LucaBrescia/theremin-psea/Theremin-frn.tex

%% This file has been automatically generated by `frontespizio'.
%% Don't use it as a model for a new frontispiece, use the
%% `frontespizio' environment in you document instead.
\documentclass [titlepage]{article}
\usepackage[utf8]{inputenc}
\usepackage [a4paper,left=1cm,bottom=1.5cm,right=1cm,top=1cm]{geometry}
\usepackage {graphicx}
\usepackage [svgnames]{xcolor}
\usepackage[nowrite,infront,standard,swapnames]{frontespizio}
\nofiles 
\fontoptionnormal 
\Universita {Brescia}
\Logo [3cm]{Logo_unibs.pdf}
\Dipartimento {Ingengeria dell'Informazione}
\Corso [Laurea magistrale]{Ingegneria Elettronica}
\Annoaccademico {2020--2021}
\Titoletto{Progetto di Sistemi Elettronici Analogici}
\Titolo {Circuito per la generazione del tono \\ (sinusoidale a frequenza variabile) per Theremin}
\Sottotitolo{Progetto n°17}
\NCandidati{Autori}
\Candidato [706005]{Luca Brescia}
\Candidato [89521]{Simone Pezzottini}
\begin {document}
\preparefrontpagestandard
\end {document}
