LucaBrescia/theremin-psea/Immagini/xr2206_pinout.pdf

SYMA2
SYMA1
WAVEA2
WAVEA1
GND
SYNCO
BIAS
FSKI

AMSI
STO
MO VCC

TC1
TC2
TR1
TR2

12345678
16
15
14
13
12
11
109
