LucaBrescia/theremin-psea/Theremin.pdf

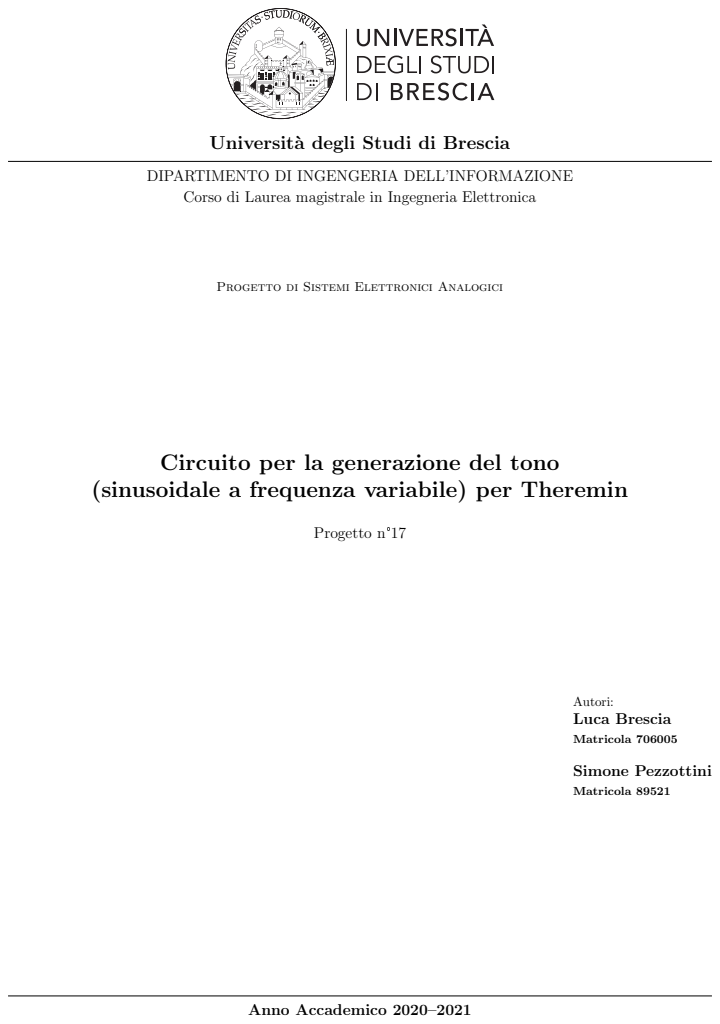
[picture p1: page 1]
Progetto n°17; Autori: Luca Brescia; Matricola 706005; Simone Pezzottini; Matricola 89521; Anno Accademico 2020–2021

Universit`a degli Studi di Brescia

DIPARTIMENTO DI INGENGERIA DELL’INFORMAZIONE
Corso di Laurea magistrale in Ingegneria Elettronica

Progetto di Sistemi Elettronici Analogici

Circuito per la generazione del tono

(sinusoidale a frequenza variabile) per Theremin

# Indice

Obiettivo | 2
1 Scelta dei componenti | 3
2 Scelte progettuali | 7
3 Risultati sperimentali | 16
4 Conclusioni | 33

# Obiettivo

Realizzazione di un tono a frequenza variabile nello spettro delle frequenze udibili [20Hz − 20kHz] utilizzando un VCO e una capacit`a variabile con il movimento di una mano seguendo lo schema a blocchi mostrato in Figura 1. Il segnale modulato avr`a un range di frequenze elevato, di conseguenza andr`a mixato ad una sinusoide a frequenza determinata, per riportare lo spettro del segnale nel range delle frequenze udibili, e opportunamente filtrato per eliminare le componenti indesiderate.

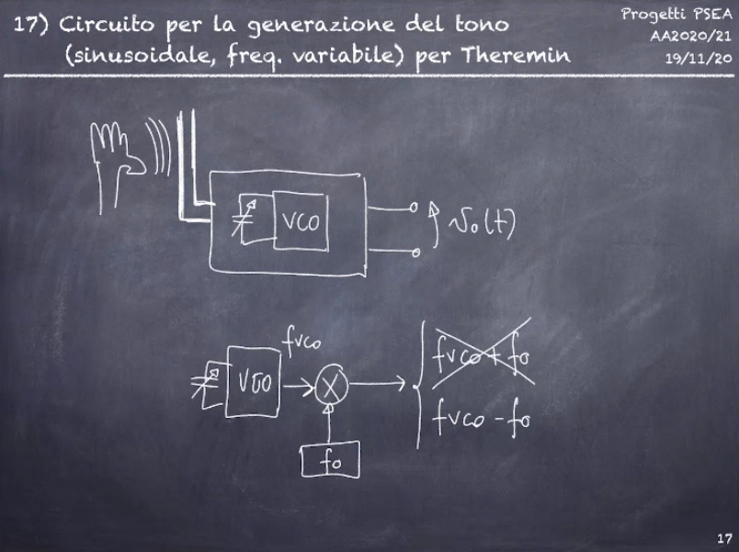
[picture p2: figure]

Figura 1: Schema generale di funzionamento di un circuito per la realizzazione di un tono.

In generale lo schema richiesto per la realizzazione del progetto potrebbe essere il seguente:

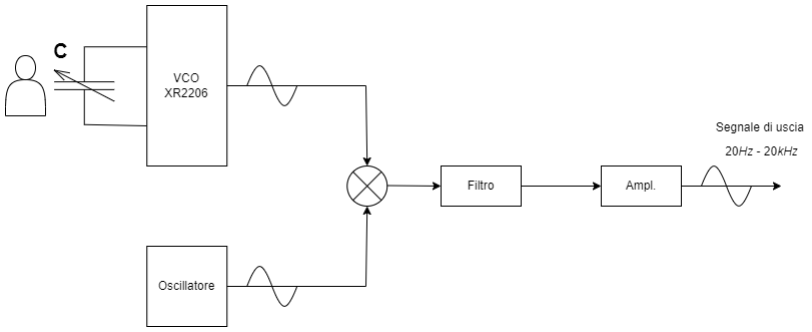
[picture p3: figure]

Figura 2: Schema a blocchi generale del progetto

# Capitolo 1

# Scelta dei componenti

I blocchi minimi necessari alla realizzazione di questo progetto sono:

1. Oscillatore sinusoidale a frequenza variabile(controllato in tensione (VCO));
2. Moltiplicatore analogico;
3. Oscillatore a frequenza fissata;
4. Filtro passa basso.
5. Filtro passa alto con Amplificazione

La scelta dei componenti `e stata fatta considerando le caratteristiche del segnale da generare. In particolare, volendo realizzare uno shift in frequenza, pertanto vi `e la necessit`a di lavorare con integrati con una banda passante adeguata. Avendo a disposizione una serie limitata di componenti si `e deciso di utilizzare i seguenti:

1. per l’ossillatore a frequenza variabile si `e scelto l’oscillatore monolitico XR2206 come VCO;
2. Il moltiplicatore analogico AD633 per lo shift frequenziale;
3. L’amplificatore operazionale LF353N per la realizzazione dell oscillatore a ponte di Wien per la generazione della sinusoide di riferimento;
4. L’amplificatore LF356P per la realizzazione di filtro passa basso.
5. L’amplificatore UA741 per la realizzazione dei filtri passa alto.

### 1.1 Amplificatori operazionali LF353N, LF356P e uA741

La scelta di questi componenti tra quelli disponibili `e stata fatta principalmente per le bande bassanti dei dispositivi.
Sono necessari componenti a banda elevata poich´e, come risulta dal capitolo 3.3, si deve lavorare con frequenze dell’ordine delle centinaia di kHz.
Infatti le bande in gioco sono di circa 3MHz per LF356P mentre 5MHz per LF353N. Ad esempio, l’UA741 ha un GBP di 1MHz tipico. I primi due operazionali sono stati scelti per:
1. LF356N per l’oscillatore armonica fondamentale
2. LF353P per il filtro passa basso del 4o ordine.

Importante osservare che l’LF356P ha al suo interno due amplificatori operazionali per cui `e stato scelto per la realizzazione del filtro del 4o ordine in modo da ridurre il numero di integrati per la realizzazione del dispositivo.Inoltre, l’LF353N, avente una GBP maggiore (5MHz ), permette di generare sinusoidi con un range di frequenze maggiore; altro motivo per cui si sono scelti i componenti come spiegato sopra. L’UA741 viene impiegato come filtro attivo passa alto del primo ordine (ecomeamplif icatoref inale) per togliere le componenti inferiori a 20Hz come richiesto dal progetto e sfruttare contemporaneamente la banda passante ridotta del dispositvo al fine di attenuare le alte frequenze indesiderate.
I motivi per cui le frequenze in gioco risultino essere elevate sono indicate nel capitolo 3.3.

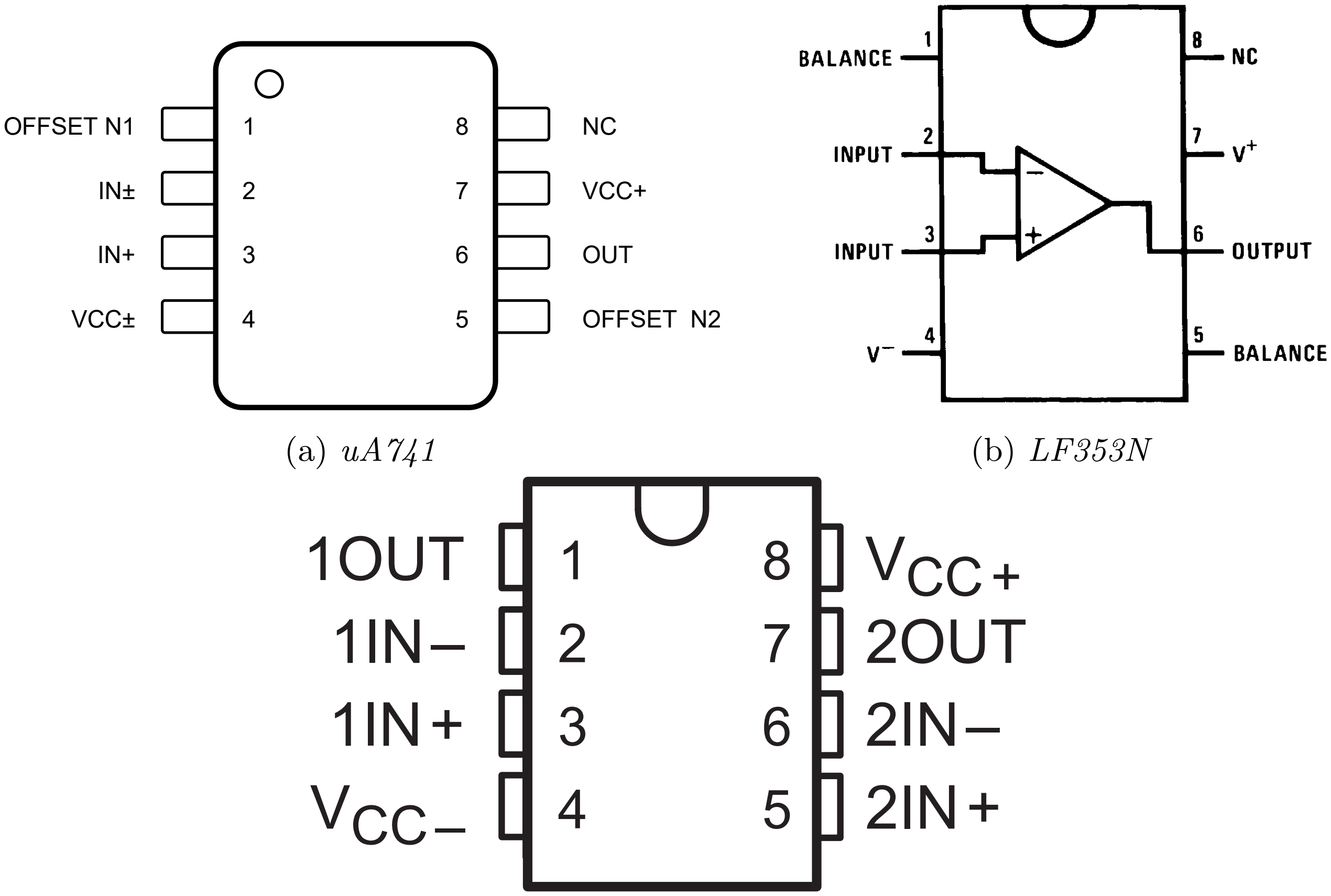
[picture p4: figure]
OFFSET N1; VCC+; OUT; 4VCC±; OFFSET N2; 1OUT 1IN– 1IN+ VCC –; VCC + 2OUT 2IN– 2IN+

(c) LF356P

Figura 1.1: PinOut dei tre Amplificatori Operazionali usati

### 1.2 Oscillatore monolitico XR2206

Si `e scelto di utilizzare XR2206 perch´e permette la generazione di diverse forme d’onda sinusoidali, onde quadre, rampe, onde triangolari ed impulsi garantendo un’alta precisione, stabilit`a e una bassa distorsione. L’ampiezza e la frequenza dei segnali in uscita sono direttamente modulabili dall’integrato, gestendo opportunamente gli ingressi. La gamma di frequenze generabili va da 0.01 Hz a 1 MHz, quindi perfetto per le specifiche richieste dal progetto. In Figura 1.2 `e mostrato lo schema a blocchi del componente.

11 SYNCO

VCO

4

VCC
12

GND
10

BIAS

Timing
Capacitor

TC1 5

TC2 6

Timing
Resistors

TR1 7

TR2 8

FSKI | 9
AMSI | 1

Current
Switches | Multiplier
And Sine
Shaper

2 STO

3 MO

13WAVEA1

14WAVEA2

15SYMA1

16SYMA2

+1

(a) Schema dei collegamenti interni

PIN DESCRIPTION

Pin # | Symbol | Type | Description
1 2 3 4 5 6 7 8 9 10 11 12 13 14 15 16 | AMSI STO MO VCC TC1 TC2 TR1 TR2 FSKI BIAS SYNCO GND WAVEA1 WAVEA2 SYMA1 SYMA2 | I O O I I O O I O O I I I I | Amplitude Modulating Signal Input. Sine or Triangle Wave Output. Multiplier Output. Positive Power Supply. Timing Capacitor Input. Timing Capacitor Input. Timing Resistor 1 Output. Timing Resistor 2 Output. Frequency Shift Keying Input. Internal Voltage Reference. Sync Output. This output is a open collector and needs a pull up resistor to VCC. Ground pin. Wave Form Adjust Input 1. Wave Form Adjust Input 2. Wave Symetry Adjust 1. Wave Symetry Adjust 2.
(b) Descrizione in dettaglio dei pin

Figura 1.2: Schema a blocchi dell’oscillatore monolitico XR2206

La frequenza di oscillazione pu`o essere determinata agendo sulla capacit`a o sulla resistenza equivalente collegate ai pin opportuni del componente, come riportato nel capitolo 2.

### 1.3 Moltiplicatore analogico AD633

La scelta del moltiplicatore analogico AD633 `e stata obbigata in quanto tra i componenti a disposizione non vi erano altre proposte. Tuttavia, garantisce delle buone prestazioni permettendo di restare nelle specifiche di progetto. Infatti, possiede elevate impedenze d’ingresso sia sugli ingressi differenziali X e Y , che sull’ingersso sommatore Z, una bassa impedenza d’uscita che permette quindi di disaccoppiare la parte a monte del circuito con quella che si trova a valle e lavora con una larghezza di banda pari ad 1 MHz e uno slew rate pari a 20 V/µS. La Figura 1.3 mette in evidenza che il componente inizia ad attenuare il segnale ad una frequenza inferiore ripetto alla banda passante teorica indicata, tagliando intorno ai 500kHz. Dal punto di vista teorico, questo non impone una limitazione ai fini del progetto.

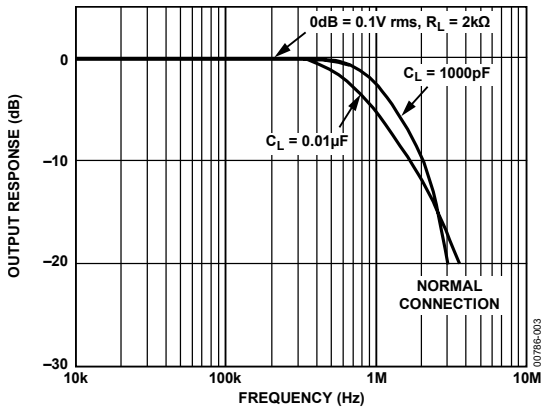
[picture p5: figure]
FREQUENCY (Hz); OUTPUT RESPONSE (dB); 10M⁰⁰⁷⁸⁶⁻⁰⁰³; NORMAL CONNECTION; 0dB = 0.1V rms, RL

Figura 1.3: Banda passante del moltiplicatore analogico AD633

La Figura 1.4 mostra sia il pinout che lo schema blocchi interno dell’AD6333. Il segnale in uscita dal mixer si calcola con la seguente equazione:

W =

(X1 − X2)(Y 1 − Y 2)
10[V ]
+ Z | (1.1)

L’Equazione 1.1 ci dice che il segnale viene attenuato di un fattore 10, quindi sar`a necessaria una compensazione negli stadi successivi come viene mostrato nella Sezione 3.5.
Analizzando il caso che gli ingressi X2, Y2 e Z collegti a massa, ovvero che diano contributo nullo. L’Equazione 1.1 diventa:

W =

X1 ∗ Y 1
10[V ]

(1.2)

Considerando che i due ingressi siano sinusoidali:

X1 = A sin(ω1t + φ1) | (1.3)
Y 1 = B sin(ω2t + φ2) | (1.4)

W =

AB
2

[cos((ω1 − ω2)t + (φ1 − φ2)) − cos((ω1 + ω2)t + (φ1 + φ2))] 1 10[V ]

| (1.5)

Aggiungendo l’ipotesi che le due sinusoidi abbiano fase nulla, l’Equazione 1.5 diventa:

W =

AB
2

[cos((ω1 − ω2)t) − cos((ω1 + ω2)t)] 1 10[V ]

| (1.6)

Dunque, all’uscita del mixer si avr`a un segnale dato dalla combinazione delle due sinusoidi in ingresso, le cui componenti spettrali saranno date una dalla somma delle componenti spettrali delle delle singole e l’altra dalla loro differenza. Quindi, inserendo un opportuno filtro passa basso, si va a selezionare solo la componente spettrale d’interesse ovvero quella compresa tra 20 Hz e 20 kHz.

AD633JN/AD633AN

1

1

A

1
10V
X1 | 1
X2 | 2
Y1 | 3

4Y2

8 +VS

### 7 W

### 6 Z

5 –VS

Figura 1.4: PinOut e schema a blocchi dell’AD633

# Capitolo 2

# Scelte progettuali

Nella realizzazione di questo progetto si deve prestare particolare attenzione allo spettro delle frequenze del segnale di uscita. Nello specifico, si deve valutare la distorsione armonica totale (THD) del segnale di uscita osservando quanto le armoniche a frequenza diversa da quella desiderata, anche generate da disturbi intrinsechi del sistema, influiscano sovrapponendosi all’armonica a frequenza desiderata. Per ridurre l’effetto delle armoniche a frequenza esterna alla banda udibile si `e scelto di introdurre cascate di filtri passa alto e passa basso in modo da creare un insieme di filtri passa-banda che producano un effetto accettabile per l’esperienza. Di seguito `e riportato lo schema a blocchi del sistema:

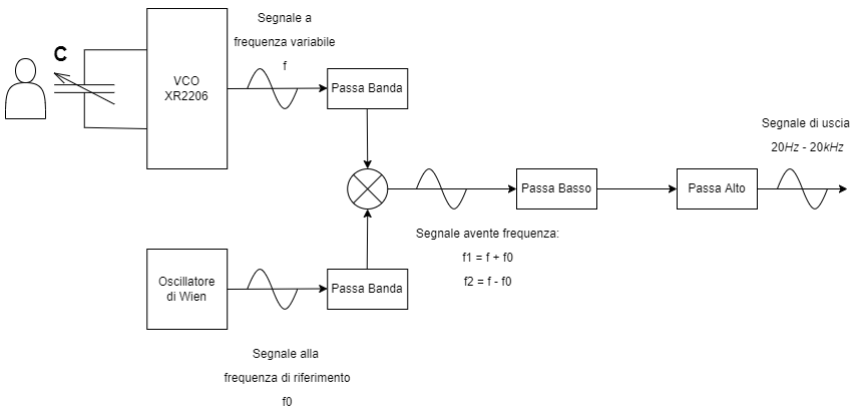
[picture p6: figure]

Figura 2.1: Schema a blocchi del sistema realizzato

Nelle Sezioni 2.1 2.2 1.3 2.4 vengono analizzate singolarmente le scelte effettuate per ogni singolo blocco del sistema.

### 2.1 VCO

Il VCO, Voltage Controlled Oscillator, `e un generatore di segnali che modifica la frequenza di oscillazione del segnale generato in funzione della tensione applicata al suo ingresso.
In relazione all’integrato utilizzato, il cui schema interno `e riportato in figura Figura 2.2, la frequenza di oscillazione f0 viene controllata da una capacit`a esterna C, detta capacit`a di timing collegata tra i pin5 e pin6 e dalla resistenza R posta in ingresso ai pin7 e pin8. Essa viene calcolata come:

f0 =

1
RC | (2.1)

Regolando il valore di R, dato dalla somma di R1+1kΩ, e di C, si imposta a piacere la frequenza di oscillazione. Nel progetto si `e scelto di utilizzare una resistenza R fissa in quanto si ha una capacit`a variabile per la regolazione della frequenza.

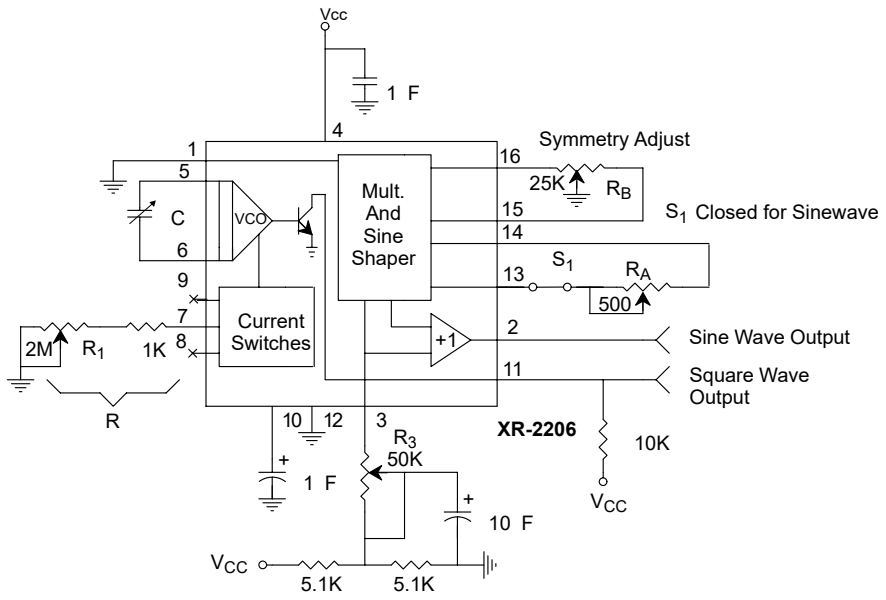
[picture p7: figure]
Symmetry Adjust; Sine Wave Output; Square Wave Output; Mult. And Sine Shaper; Current Switches; VCC; VCO; Vcc; S1 Closed for Sinewave

Figura 2.2: Schema a blocchi interno dell’oscillatore monolitico XR2206

Come consigliato da datasheet, per garantire una buona stabilit`a in temperatura, si `e scelto di utilizzare valori di R compresi tra 4kΩ < R < 200kΩ e valori di C compresi tra 1µF < C < 100µF.
Avendo una capacit`a variabile, in quanto dipendendente dalla posizione della mano dell’utente e dalla geometria dell’antenna realizzata, si `e scelta una R di 100kΩ per cercare di rispettare, almeno in parte, il range fornito dal datasheet per garantire una buona stabilit`a in temperatura.

### 2.2 Oscillatore sinusoidale di Wien

Per la realizzazione di un segnale sinusoidale a frequenza fissata si `e scelto di utilizzare un oscillatore in configurazione a ponte di Wien auto-avviante, il cui schema `e riportato in Figura 2.3

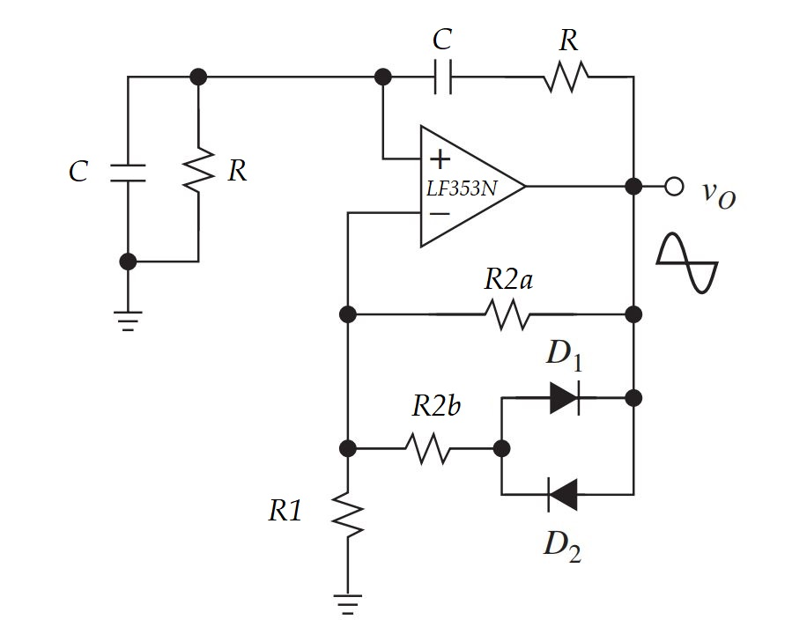
[picture p8: figure]

Figura 2.3: Schema generale di un oscillatore a ponte di Wien auto-avviante. A sinistra lo schema utilizzato per il progetto.

Analizzando la f.d.t del circuito, riportata nell’equazione 2.2 si osserva che il prodotto A · B deve essere 1, overo che sia soddisfatta la condizione di risonanza ω = ω0.

T(jω) =

1 + R2
R1
3 + j(

ω
ω0

−

ω0
ω

)

(2.2)

Il blocco di forward A `e rappresentato dal guadagno del circuito ovvero:

A = 1 +

R2
R1

(2.3)

Mentre, in presenza di R e C di valore unico, il blocco di feedback B `e rappresentato dall’equazione:

B =

1
3 + jωRC − j

1
ωRC

(2.4)

Da questo si possono avere tre casi:
1. T(jω) < 1: si ha una situazione stabile, in cui i segnali tendono a zero. Perch´e si hano due poli complessi coniugati a parte reale negative, che danno origine ad una sinusoide smorzata esponenzialmente.

2. T(jω) > 1: si ha una situazioneinstabile, dove ogni disturbo con contributo spettrale vicino ad ω0 viene amplificato rigenerativamente. Pertanto l’amplificatore operazionale satura. Questo avviene perc´e si hanno due poli complessi coniugati a parte reale positiva, che danno origine ad una sinusoide con ampliezza crescente esponenzialmente.
3. T(jω) = 1: si ha una situazione di stabilit`a. Perch´e si hanno due poli complessi coniugati a parte reale nulla, immaginari puri, che danno origine ad una sinusoide con ampiezza costante.

Per l’innesco delle oscillazioni `e necessario che il guadagno ad anello aperto sia inizialmente A·B > 1 ed A > 3 per poi assestarsi a A·B = 1 ed A = 3. La tecnica pi`u semplice consiste nel disporre due diodi in antiparallelo lungo l’anello di retroazione dell’amplificatore operazionale. Quando VO `e bassa i diodi presentano un’alta resistenza differenziale mentre all’aumentare di VO essa diminuisce.
Per rispettare le condizioni di lavoro imposte, il guadagno A deve essere posto, circa, all’85% del suo valore nominale (A=2,5 — 2,55) cos`ı si fa in modo modo che A > 3 all’avvio che poi si riduce ad A=3 a regime.

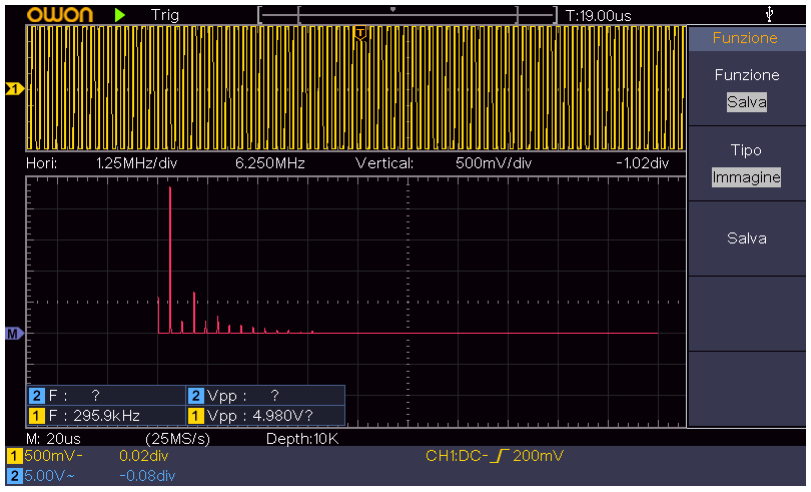
[picture p9: figure]

Figura 2.4: FFT della sinusoide a 295kHz in uscita dall’oscillatore acquisita tramite oscilloscopio

La frequenza di oscillazione si ottiene con l’Equazione 2.5:

f0 =

1
2πRC | (2.5)

Per la valutazione della distorsione della sinusoide ottenuta si utilizza il calcolo del THD riportato nell’Equazione 2.6:

T HD(%) = 100 ·

qP∞
2 V

2
n
V1
| (2.6)

Tutti i valori di tensione devono essere in RMS:

VRMS =

V
√
2

(2.7)

La presenza di un THD pi`u o meno accettabile `e indice di un andamento sinusoidale in uscita pi`u o meno ideale, ossia avente una fft che presenta una sola riga spettrale. L’aggiunta di nuove armoniche pu`o essere cuasata dalla sensibilit`a alle temperature dell’oscillatore di Wien, che porta anche ad una variazione delle ampiezze. Un’altra possibile fonte di disturbi e/o distorioni `e la saturazione dell’amplificatore utilizzato per realizzare l’oscillatore, bisogna quindi essere sempre attenti a non portare l’amplificatore a saturare il segnale.

### 2.3 Moltiplicatore analogico

Come segue dalla teoria dei segnali, alla moltiplicazione di due segnali nei tempi corrisponde la convoluzione degli stessi in frequenza. Questo porta ad ottenere due sinusoidi centrate a frequenza ω1 + ω2 e ω1 − ω2.
In Figura 2.5 viene mostrato il risultato ottenuto moltiplicando una sinusoide ottenuta precedentemente con l’oscillatore di Wien, illustrato nella Sezione 2.2, avente una ω0 di 45kHz, e una sinusoide generata dal generatore di funzione ad una frequenza di 20kHz.

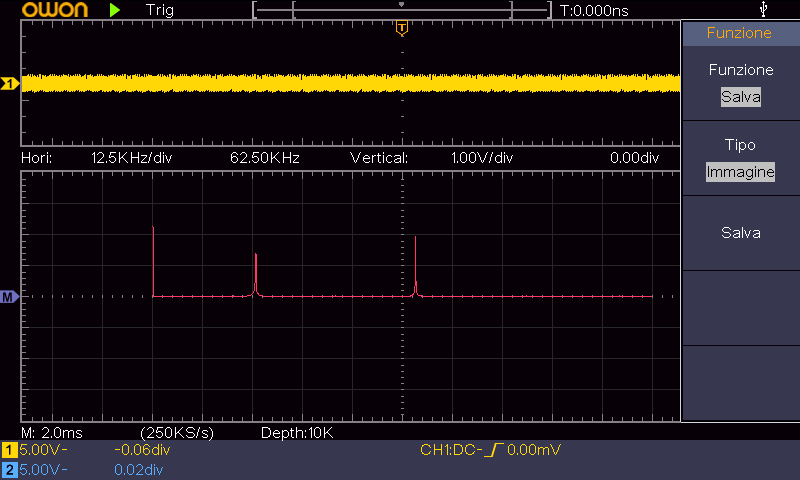
[picture p10: figure]

Figura 2.5: FFT del segnale in uscita dall’AD633, con test tra Oscillatore di Wien avente ω0 = 45kHz 12V picco e generatore di funzione con segnale 20 Khz e 2.5V picco.

Essendo i due segnali di 20kHz e 45kHz rispettivamente, dalla Figura 2.5 si pu`o notare come vengano generate due sinusoidi aventi armoniche fondamentali a (45 −20)kHz e (45 + 20)kHz. Inoltre, le ampiezze misurate risultano comparabili con i risultati teorici in quanto l’ampiezza di picco dei due segnali `e di 12V e 2.5V rispettivamente, che vengono moltiplicati tra loro e scalati di un fattore 10, come specificato nel datasheet del componente. Sempre in riferimento alla Figura 2.5 si pu`o notare anche come le due ampiezze non siano uguali: questo `e un errore dovuto alla non-linearit`a del componente. Tuttavia, per la nostra applicazione questo errore `e irrilevante in quanto interessa maggiormente la componente frequenziale del segnale.

### 2.4 Filtro LP del quarto ordine

Il prodotto di due sinusoidi del mixer porter`a in uscita due sinusoidi a frequenze diverse ovvero una sar`a ωwien + ωV CO e l’altra a ωwien − ωV CO. Per rientrare nelle specifiche di progetto, `e stato necessario introdurre un filtro passa-basso che permetta di ottenere in uscita al sistema solo la componente armonica ωwien − ωV CO.
Volendo realizzare un filtro molto selettivo e, avendo il componente LF353P al suo interno due amplificatori, si `e scelto di utilizzare un filtro attivo di ordine 4, realizzandolo tramite un filtro di Chebychev con due celle Sallen-Key in casacata.

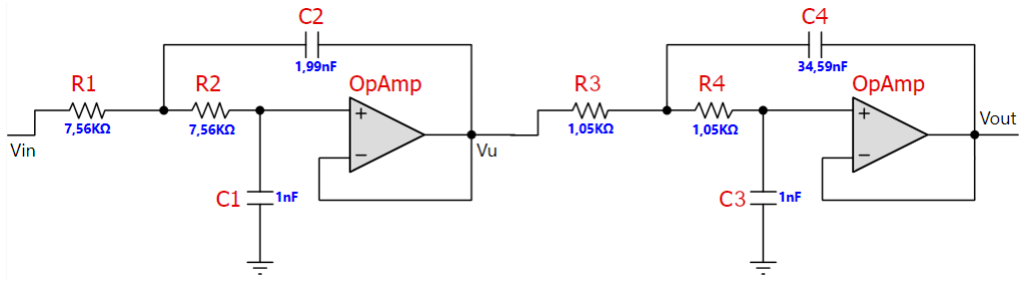
[picture p11: figure]

Figura 2.6: Filtro attivo di ordine 4.

La risposta in frequenza teorica del filtro risulta essere in modulo quella riportata nel diagramma di Bode mostrato in Figura 2.7.

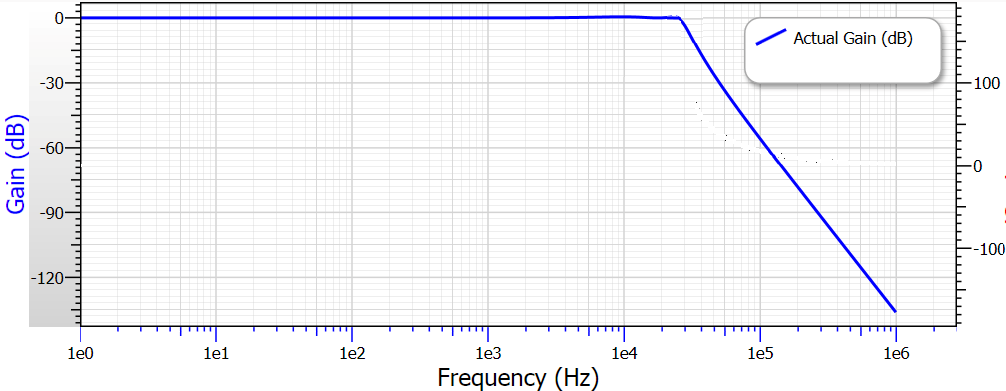
[picture p12: figure]

Figura 2.7: Diagramma di Bode del modulo del filtro.

La funzione di trasferimento del filtro del quarto ordine pu`o essere vista come il prodotto in cascata delle funzioni di trasferimeto delle due celle Sellen-Key del secondo ordine.
La funzione della prima cella risulta:

H1(s) = Vin
Vu

=

1
1 + sC1(R1 + R2) + s

2C1C2R1R2

(2.8)

Mentre la funzione di trasferimento della seconda cella risulta essere:

H2(s) = Vu

Vout

=

1
1 + sC3(R3 + R4) + s

2C3C4R3R4

(2.9)

La funzione di trasferimento totale del filtro sar`a quindi data dal prodotto delle due Equazioni 2.8e 2.9:

H(s) = H1(s)H2(s) = Vin
Vu

Vu

Vout

=

Vin

Vout

(2.10)

### 2.5 Filtro passa alto del primo orine con amplificazione

Come mostrato nello schema riportato in figura 2.1, il sistema presenta come ultimo blocco un filtro passa alto, per tagliare tutte le frequenze inferiori ai 20 Hz, come da specifica. Inoltre, oltre a filtrare le basse frequenze si effettua anche un’amplificazione per compensare il fattore di attenuazione introdotto dal mixer.

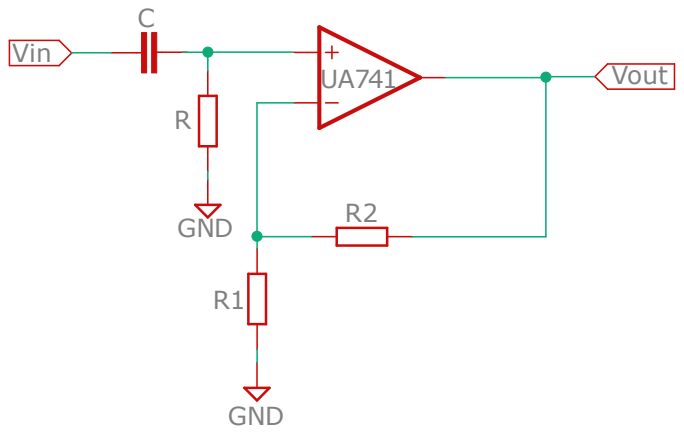
[picture p13: figure]
GND; Vin; Vout

Figura 2.8: Schematico del filtro passa alto attio del primo ordine, con guadagno per compensare l’attenuazioen itordotta dal mixer. Posto in uscita dal filtro passa basso del quarto ordine.

La funzione di trasferimetno del filtro pu`o essere vista come il prodotto di due dieversi blocchi. Il blocco di guadagno non invertente riportato nell’equazione 2.11, ovveor il blocco di retroazione. Che per compensare il fattore di attenuazione introdotto dal mixer il guadagno dovr`a essere pari a 10.

A = 1 +

R2
R1

(2.11)

Il secondo blocco invece conprende la parte di filtraggio e la sua funzione di trasferimento `e quella riportata nell’eqauzione 2.12.

H(jω) = | jωRC
1 + jωRC | (2.12)

Moltiplicando l’equazione 2.11 con l’equazione 2.12 e passando nel dominio di Laplace, ovvero ponendo jω = s, si ottine la finzione di trasferimento complessiava del filtro attivo riportata nell’equazione 2.13.

H(s) = sRC
1 + sRC (1 + R2
R1
) | (2.13)

La frequenza di taglio si ottine con la formula riportata nell’equazione 2.14

ft =

1
2πRC | (2.14)

Imponendo una C pari a 47nF, per ottenere una ft pari a 20 Hz, si deve avere una R pari a 169.3kΩ.

### 2.6 Filtro passa banda passivo

Anche se nello schema riportato in figura 2.1 i filtri passa banda vengono posti all’inizio, sono stati messi come ultimo sezione in quanto la loro necessit`a si `e presentata solo dopo una prima anlisi dei segnali in uscita dall’XR2206 edall’oscillatore riportato nella sezione 2.2. Visto che i due segnali impiegati nella misurazioni presentavano delle componenti in continua, sopratutto il segnale in uscita dall’XR2206 che introduce un offset per garantire l’oscillazione con un’alimetazione singola, come spiegato nella sezione 1.2; mentre l’oscillatore nella sezione 2.2 presenta un THD elevato. Quindi, al fine di evitare di ottenere ulteriore distorsione in uscita dal mixer si `e deciso di introdurre il filtro passa banda passivo riportato in figura 2.9.

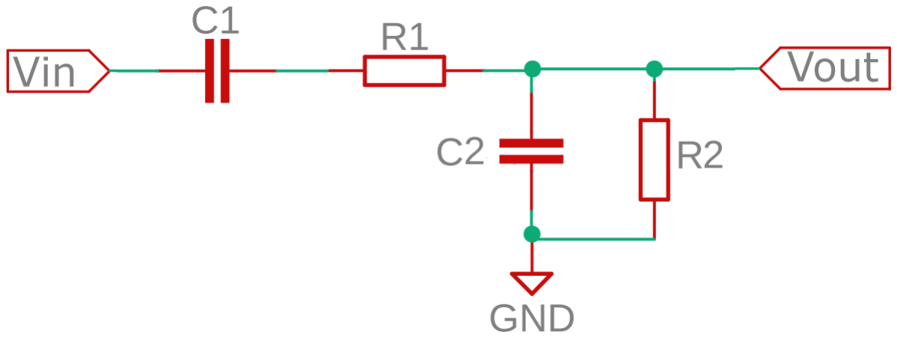
[picture p14: figure]

Figura 2.9: Schematico del filtro passa banda passivo meso in uscita dal XR2206 e in uscita all’oscillatore riportato nella sezione 2.2

La funzione di trasferimento del filtro `e riportata nell’equazione 2.15.

H(s) =

s
C2R1
s

2 + s(

1
C2R2

+

1
C1R1

+

1
C2R1

) + 1 C2R2C1R1

(2.15)

Si possono notare due poli il primo in kHz e il secondo in kHz e di uno zero nell’origine. Questi garantiscono il filtraggio della continua come desiderato ed una prima attenuazione delle frequenze oltre il valore massimo che consente di demodulare in uscita la sinusoide con la frequenza compresa nell’intervallo imposto dalle specifiche.
Si pu`o notare la presenza di un patitore di tensione. Per evitare un attenuazione del segnale si `e deciso di iporre R2 molto maggiore di R1 in modo che l’equazione del partitore di tensione, riportato nell’equazione 2.16, diventi l’equazione 2.17.

Vout = Vin

R1
R1 + R2

(2.16)

Vout ∼ VinseR1 >> R2 | (2.17)
In figura 2.10 riporta il diagrama di Bode del modulo relativo al filtro passa banda progettato.

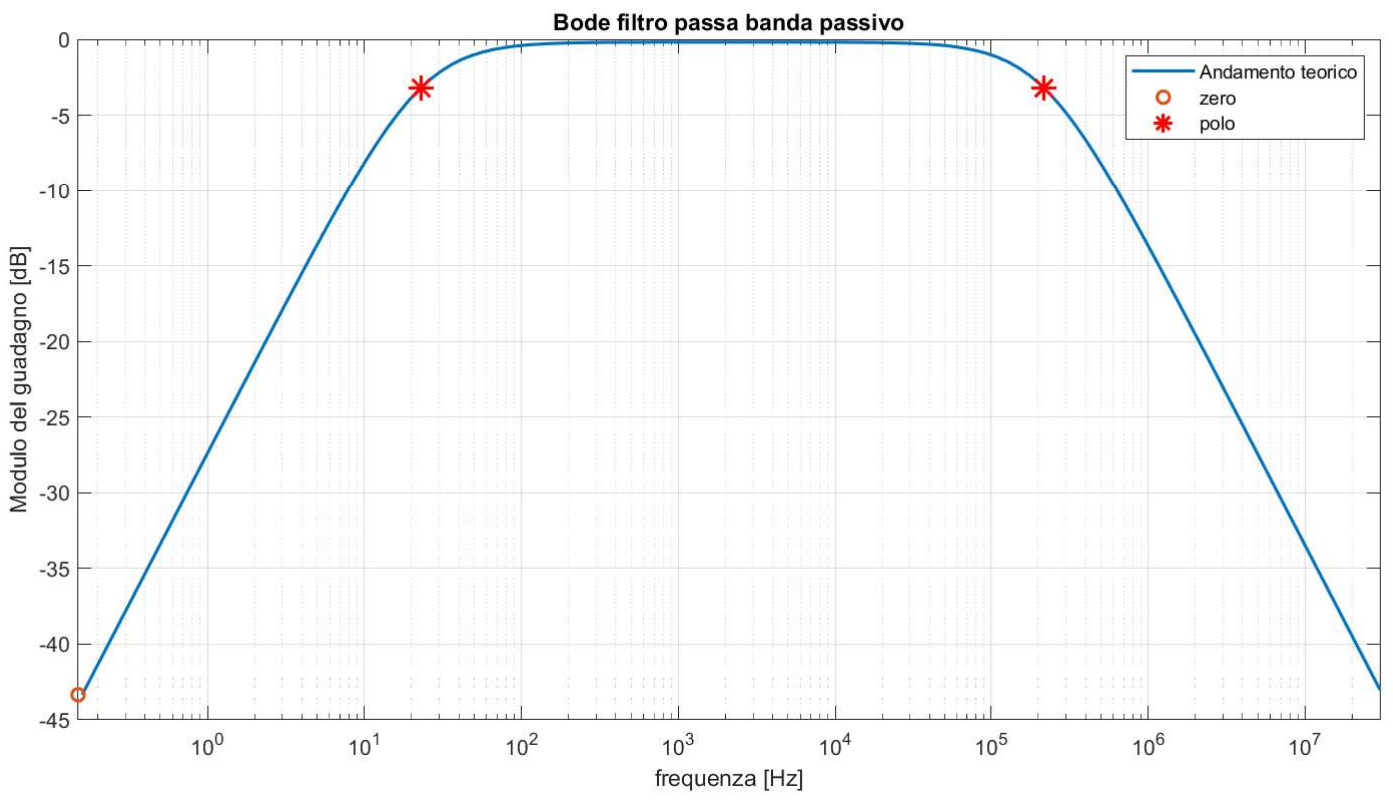
[picture p15: figure]

Figura 2.10: Diagramma di Bode del filtro passa banda passivo con evidenziati il polo e gli zeri.

# Capitolo 3

# Risultati sperimentali

### 3.1 XR2206

Per la realizzazione della sinusoide a frequenza variabile si `e fatto riferimento al datasheet del componente scegliendo come valori di partenza quelli mostrati in esempio. La capacit`a variabile `e stata realizzata con un supporto rigido e della carta di alluminio creando una struttura simile ad una bandiera. Il tutto `e stato collegato come mostrato in Figura 3.1.

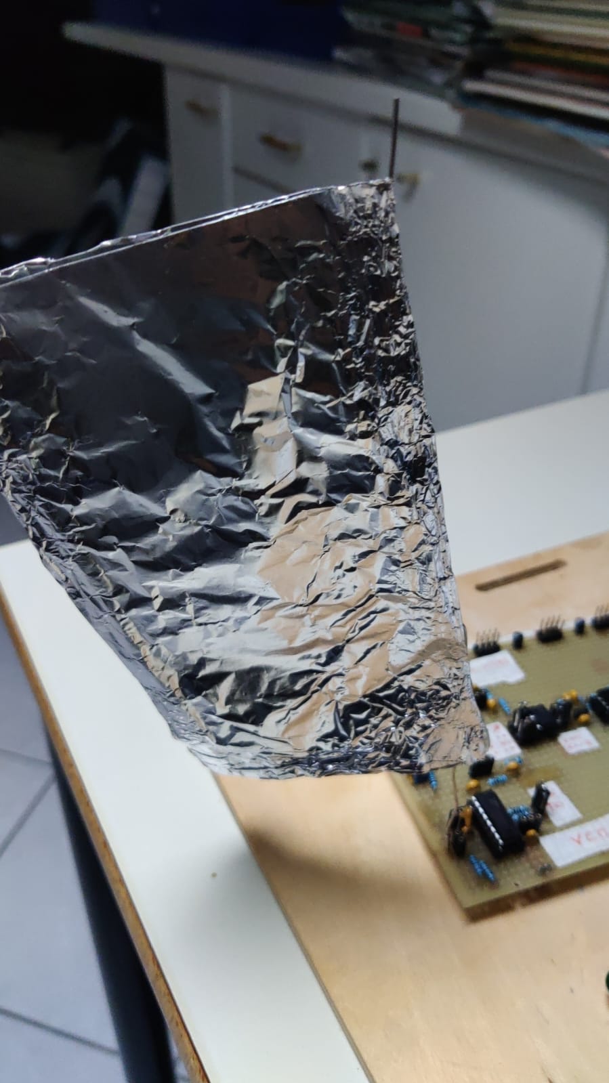
[picture p16: figure]

Figura 3.1: Foto dell’antenna utilizzata come capacit`a variabile

Le prestazioni ottenute con questo tipo di antenna sono mostrate in Figura 3.2 e in Figura
3.3. Dalle figure si pu`o osservare le sinusoidi in uscita dall’XR2206 in presenza dell’antenna a bandiera e in assenza della mano dell’utente, ovvero l’oscillazione a ”riposo” dell’oscillatore.
E importante notare come dalla ` | Figura 3.3 venga evidenziata l’attenuazione e lo sfasamento
del segnale dovuti all’effetto del filtro passa banda. Tuttavia, il filtro migliora le prestazioni di uscita dell’oscillatore. Infatti, gi`a dalla Figura 3.2 si pu`o apprezzare la buona riuscita del sistema in termini di segnale sinusoidale generato. Prestazioni che possono essere quantificate con un’analisi di tipo spettrale.

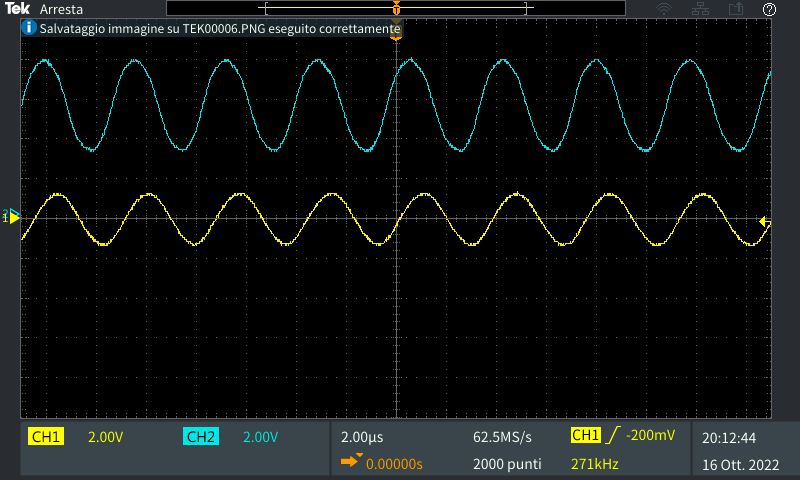
[picture p17: figure]

Figura 3.2: Confronto tra i segnali in uscita dall’oscillatore monolitico XR2206 prima (in bianco) e dopo (in giallo) il fitro LP in cascata.

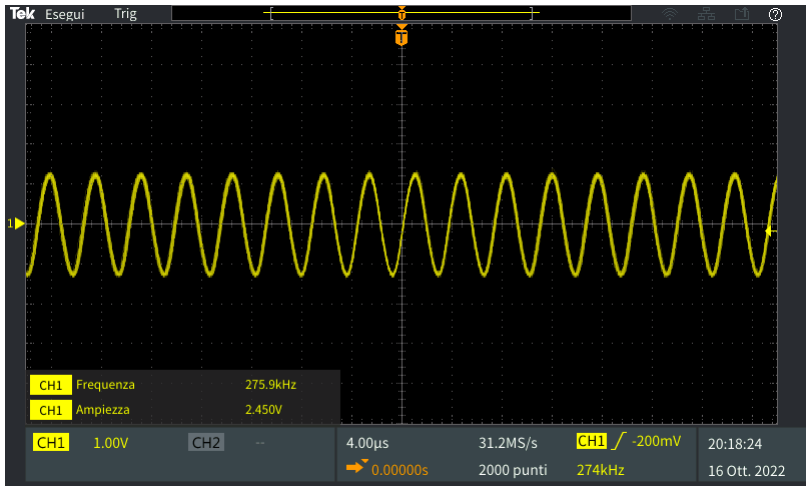
[picture p18: figure]

Figura 3.3: Segnale in uscita dal blocco XR2206 + LP.

La figura 3.4 mostra la FFT in uscita dall’XR2206 prima del filtro (segnale in bianco) e dopo il filtro (segnale in giallo). I due segnali oscillano alla stessa frequenza fondamentale e sono stati visualizzati con scala differente per poterne apprezzare l’intera riga spettrale. Si nota che l’armonica dopo il filtro (in giallo) presenta un miglioramento del THD rispetto a quella non filtrata (in bianco) in quanto le armoniche a frequenza diversa dalla fondamentale vengono attenuate, anche se la riduzione in ampiezza interessa anche la fondamentale. La tabella 3.1 mostra i valori numerici ottenuti dal calcolo del THD sostituendo i valori numerici delle ampiezze del segnale risultante nell’Equazione 2.6.

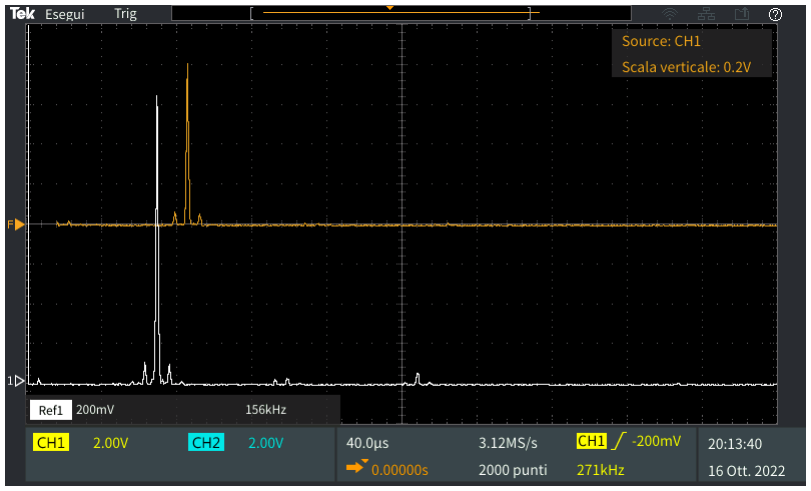
[picture p19: figure]

Figura 3.4: Confronto tra le FFT del segnale in uscita dall’oscillatore monolitico XR2206 prima e dopo il filtro LP in cascata.

Armonica | Ampiezza [mV] | THD (%)
Fondamentale | 800 | 7.071
a armonica 2 | 40
a armonica 3 | 40

Tabella 3.1: Misure in ampiezza delle componenti armoniche e calcolo del THD della sinusoide in scita dall’XR2206 filtrata dal filtro passa-banda

### 3.2 Oscillatore di Wien

In figura 2.3 `e riportato lo schematico dell’oscillatore di Wien utilizzato per generare la sinusoide di riferimento alla frequenza di 245 kHz. La frequenza `e stata ottenuta sostituendo nell’equazione 2.5 il valore di C pari a 330pF e una R pari a 2kΩ. Inoltre si `e scelto di usare una R2a di 2MΩ per garantire un passaggio di corrente tra uscita e ingresso.

Figura 3.5: Schematico dell’oscillatore di Wien utilizzato

La figura 3.6 mostra l’uscita dell’oscillatore di Wien. In azzurro si pu`o notare che la sinusoide satura sulla semionda negativa e le pendenze di salita a discesa sono differenti. Questo accade quando il valore di resistenza utilizzato dei potenziometri `e comparabile. La saturazione del segnale di uscita dell’integrato porta all’introduzione di altre armoniche oltre alla fondamentale, come mostrato dal segnale in bianco mostrato in Figura 3.7.

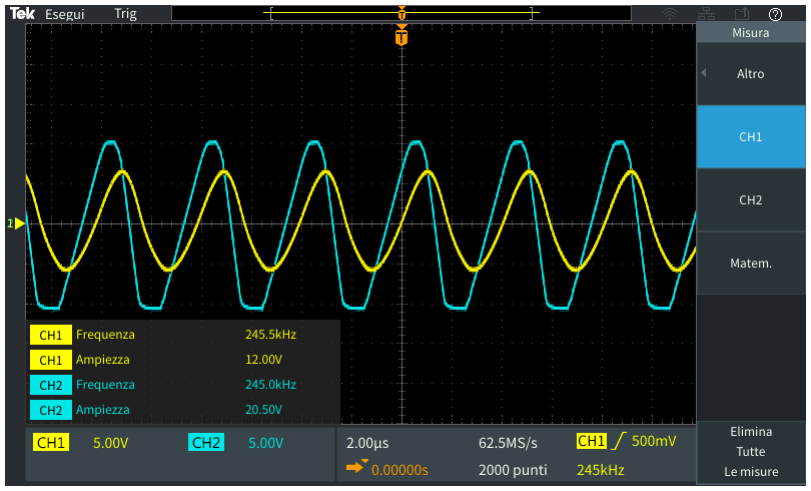
[picture p20: figure]

Figura 3.6: Confronto tra i segnali in uscita dall’oscillatore di Wien prima e dopo il fitro BP in cascata.

Per risolvere questo problema `e stato aggiunto un filtro passivo all’uscita dell’oscillatore. Il filtro `e di tipo passa banda formato da un condensatore per tagliare la continua, seguito da un passa basso RC (R = 7.5kΩ; C = 100pF; fc = 212kHz). L’aggiunta di questo filtro porta un notevole miglioramento del segnale di uscita. Tale miglioramento `e osservabile sia in Figura 3.6 (sinusoide in giallo), dove si pu`o notare l’assenza di saturazione delle semionde e fronti di salita e discesa pressoch´e identici, che in figura 3.7 dove di pu`o notare la notevole riduzione delle armoniche nello spettro del segnale.
Tuttavia, l’aggiunta di un filtro di questo tipo porta ad un’attenuazione anche dell’armonica fondamentale e ad uno sfasamento di 90° in ritardo rispetto alla sinusoide originale. L’attenuazione `e dovuta alla scelta della frequenza di taglio del filtro (212kHz), che quindi inizier`a a tagliare circa 20/30kHz prima della fondamentale dell’oscillatore di Wien che `e generata a 245kHz. Lo sfasamento invece `e dovuto al filtro del primo ordine passivo.

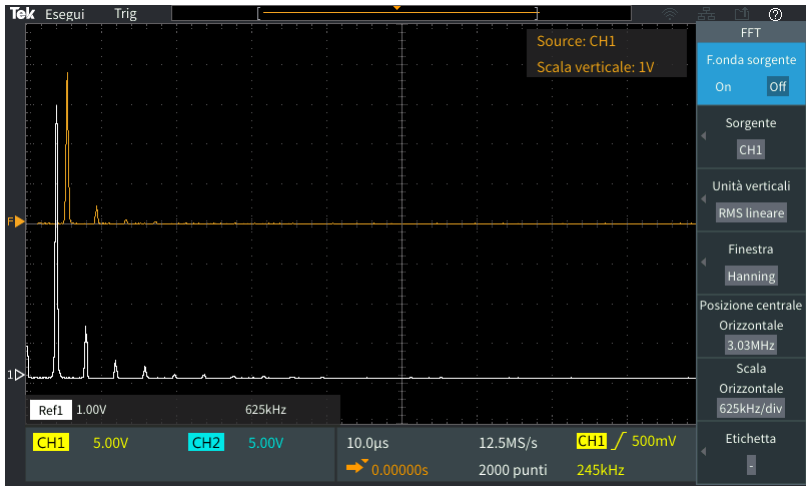
[picture p21: figure]

Figura 3.7: Confronto tra le FFT del segnale in uscita dall’oscillatore di Wien prima e dopo il filtro BP in cascata.

Un altro riscontro lo si ha con il calcolo del THD del segnale in uscita dall’oscillatore il cui risultato ottenuto l’Equazione 2.6 `e mostrato nella Tabella 3.2. Invece, nella tabella 3.3 `e riportato il valore del THD ottenuto sempre dall’Equazione 2.6 riferito al segnale risultante in uscita al filtro passa banda passivo. Confrontando i due risultati ottenuti, si pu`o osservare un effettivo miglioramento del THD della sinusoide di riferimento.

Armonica | Ampiezza [mV] | THD (%)
Fondamentale | 6800 | 19.96
2 a armonica | 1200
3 a armonica | 600
4 a armonica | 200
5 a armonica | 50

Tabella 3.2: Ampiezza delle armoniche del segnale in uscita dall’oscillatore di Wien.

Armonica | Ampiezza [mV] | THD (%)
Fondamentale | 3800 | 10.61
2 a armonica | 400
3 a armonica | 50

Tabella 3.3: Ampiezze delle armoniche del segnale filtrato con il filtro passa basso in cascata all’oscillatore di Wien.

### 3.3 Mixer

L’AD633 rappresenta il blocco del mixer nel nostro sistema. Il suo compito `e moltiplicare tra loro le due sinusoidi in ingresso. Le sinusoidi interessate sono quella di riferimento dell’oscillatore di Wien e quella in uscita dal VCO. Quest’ultima sar`a variabile e dipender`a dalla distanza della mano rispetto all’altro estremo della capacit`a variabile (bandiera in alluminio).
Una delle problematiche riscontrate durante l’utilizzo del mixer `e stata la manifestazione di un offset del segnale dovuto all’impossibilit`a degli ingressi di scaricare le correnti di bias verso massa. Questo ha portato alla comparsa di offset negativo e alla cancellazione delle altre armoniche in uscita.
La soluzione si `e trovata inserendo una resistenza di valore 680kΩ agli ingressi del mixer, creando un percorso verso massa per le correnti di bias. La scelta di tale valore `e dovuta al compromesso tra l’ingresso ad alta impedenza dell’AD633 e il partitore formato con la resistenza del filtro. La scelta di un valore errato produrrebbe un’attenuazione indesiderata del segnale di ingresso al mixer. Il resistore scelto evita l’attenuazione del segnale e salvaguarda l’alta impedenza del componente. Ci`o che si `e ottenuto `e mostrato in Figura 3.8, dove `e possibile osservare il risultato della moltiplicazione di due segnali sinusoidali nel dominio delle frequenze.

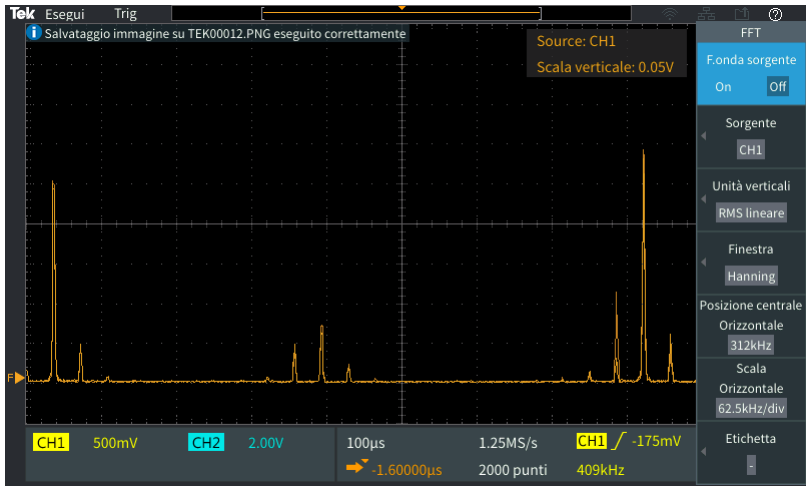
[picture p22: figure]

Figura 3.8: FFT in uscita dal mixer AD633 senza filtraggio

Quello che si evince osservando la figura 3.8 `e che le armoniche presenti alle frequenze superiori a quelle di interesse nei due segnali e in ingresso all’integrato, visibili nelle figure 3.8 e 3.7, comportano la presenza delle armoniche fondamentali conseguenti al prodotto tra le due sinusoidi. Inoltre, l’ampiezza maggiore delle armoniche di alta frequenza rispetto a quelle in bassa frequenza, `e dovuto alla sovrapposizione dei prodotti misti tra armoniche indesiderate e fondamentali dei segnali. In particolar modo, i prodotti in cui le frequenze si sommano, si sovrappongono a quelli in cui le frequenze si sottraggono. La figura 3.9 evidenzia le armoniche citate.

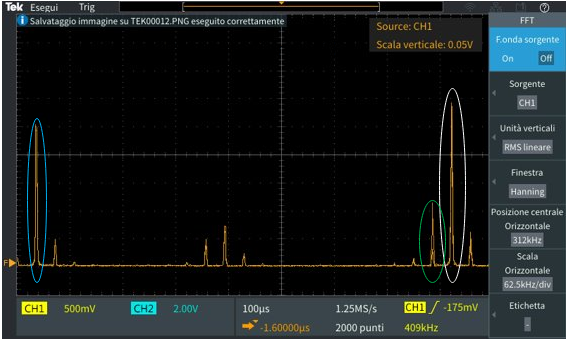
[picture p23: figure]

Figura 3.9: Armoniche coinvolte nella sovrapposizione messe in evidenza

### 3.4 Filtro passa basso di ordine 4

In uscita dal mixer `e stato necessario inserire un filtro passa basso per eliminare le frequenze superiori ai 20kHz, come richiesto da specifica di progetto. Esso `e necessario per eliminare le componenti date dalla somma delle frequenze in uscita al mixer risultanti dell’Equazione 1.2. Infatti, dati due segnali del tipo V1 = A1 · sin(ω1t) e V2 = A2 · sin(ω2t), il segnale risultante dalla moltiplicazione analogica tra i due sar`a dato dall’equazione 3.1:

Vm = V1 · V2 =

A1A2
2
[sin((ω1 + ω2)t) + sin((ω1 − ω2)t)] | (3.1)

La figura 3.10 mostra il comportamento in frequenza dell’LF353P, ovvero il componente utilizzato per la realizzazione del filtro passa basso di ordine quattro.
La scelta di un filtro del quarto ordine `e stata fatta sia per garantire un’atteuazione sufficiente delle armoniche successive ai 20KHz sia perch´e l’LF356P contiene al suo interno due operazionali. Quindi per evitare di lasciare flottanti dei pin che sarebbero potuti diventare una fonte aggiuntiva di rumore, si `e deciso di utilizzare il componente al meglio delle possibilit`a. L’andamento del filtro ottenuto `e mostrato in Figura 3.11, la quale mostra che le scelte progettuali sono state corette, in quanto i dati sperimentali rispecchiano l’andamento teorico del filtro. Come si pu`o osservare in Figura 3.11 i due andamenti sono molto simili.

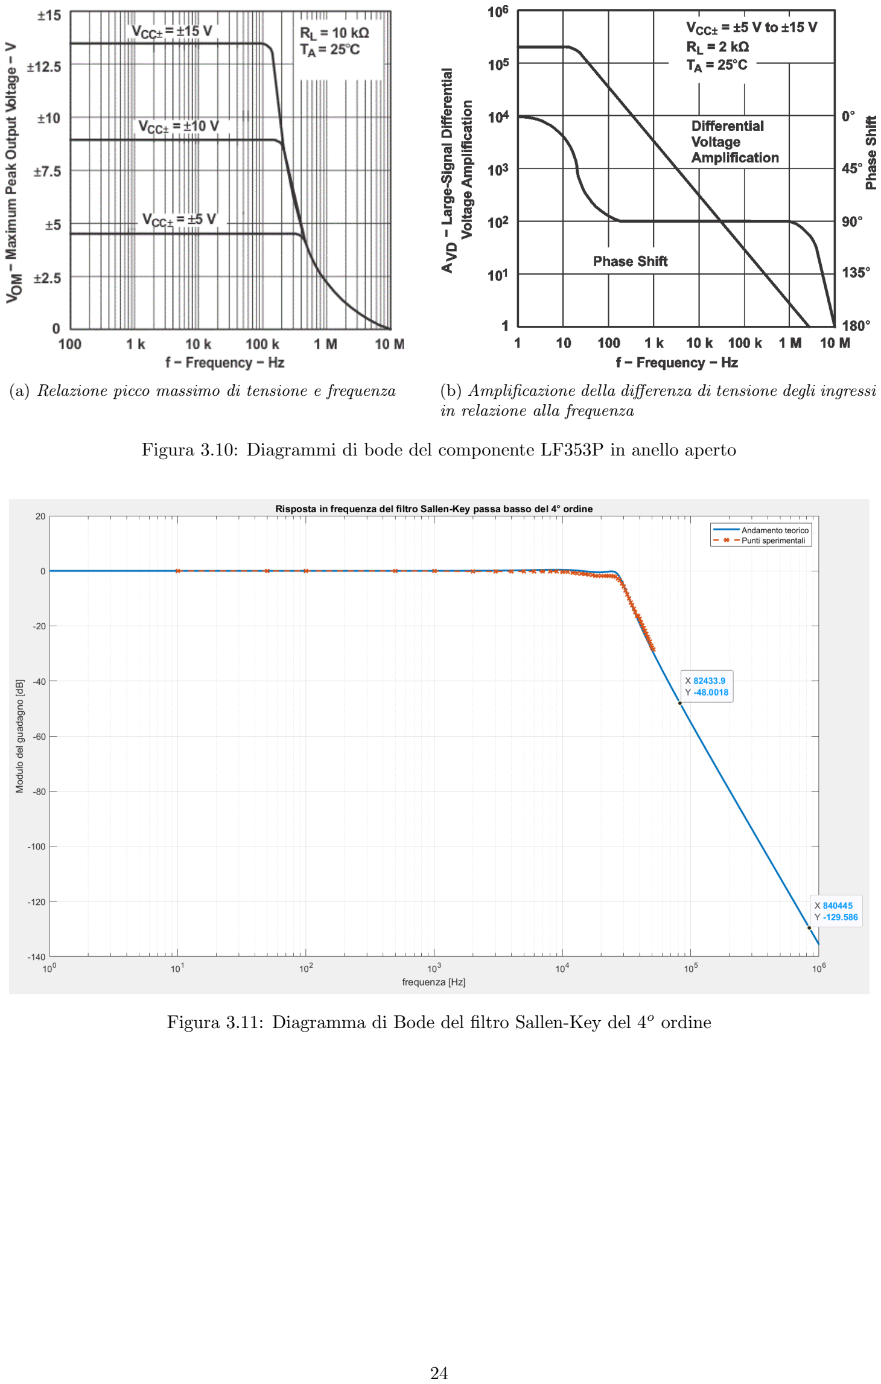
[picture p24: page 25]

(a) Relazione picco massimo di tensione e frequenza (b) Amplificazione della differenza di tensione degli ingressi in relazione alla frequenza

Figura 3.10: Diagrammi di bode del componente LF353P in anello aperto

Figura 3.11: Diagramma di Bode del filtro Sallen-Key del 4o ordine

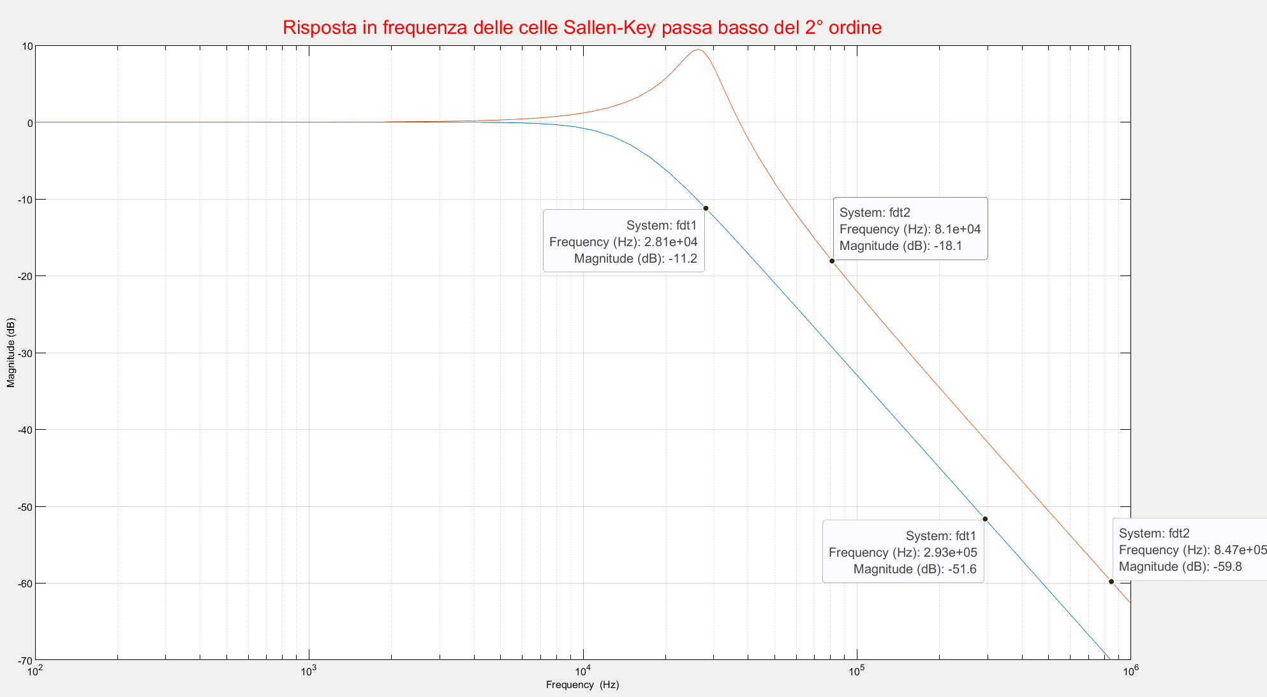
[picture p25: figure]

Figura 3.12: Diagramma di Bode delle celle Sallen-Key del 2o ordine, che compongono il filtro del 4o ordine

### 3.5 Filtro passa alto del primo ordine

Per eliminare la componente in continua in uscita dal mixer analogico `e necessario un filtro passa alto. L’elemento disaccoppiante pi`u semplice da poter inserire `e una capacit`a, tra uscita del mixer e l’uscita del sistema completo. Dovendo rispettare da specifiche una frequenza minima del segnale di uscita di 20Hz si `e deciso di optare per la realizzazione di un filtro passa alto con frequenza di taglio di 20Hz. Tuttavia si `e scelto di utilizzare un filtro attivo per recuperare l’attenuazione di fattore 10 imposta dall’AD633, oltre che per disaccopiare il circuito dal carico. Da datasheet il prodotto banda guadagno (GBP) dell’uA741 risulta essere di 1MHz in anello aperto. Tuttavia, utilizzando un guadagno di fattore 10 in anello chiuso, la banda passante del componente `e ridotta a 100kHz. In questo modo `e possibile ottenere un filtro passa banda con banda pari a 20Hz - 100KHz. Questo aiuta ad attenuare ulteriormente tutte le componenti in alta frequenza. Come mostra la Figura 3.13, l’ampiezza massima del segnale in uscita dal componente viene ridotta per le alte frequenze. Ci`o implica che l’uscita finale del sistema osciller`a con un ampiezza massima di ±6V.
V ±20

f – Frequency – Hz

10k1k | 1M100k

# OM – Maximum Peak Output Voltage – V±18

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
VCC+ = 15 V
VCC – = –15 V
RL = 10 kΩ
TA = 25°C

100

Figura 3.13: Ampiezza massima del segnale di uscita in relazione alla sua frequenza

Un’altro parametro importante da tenere in considerazione `e il THD che da datasheet risulta essere solo dello 0.06% del segnale in ingresso. Quindi l’utilizzo di questo componente non introduce distorsione armonica significativa al sistema visti i valori esposti in precedenza.

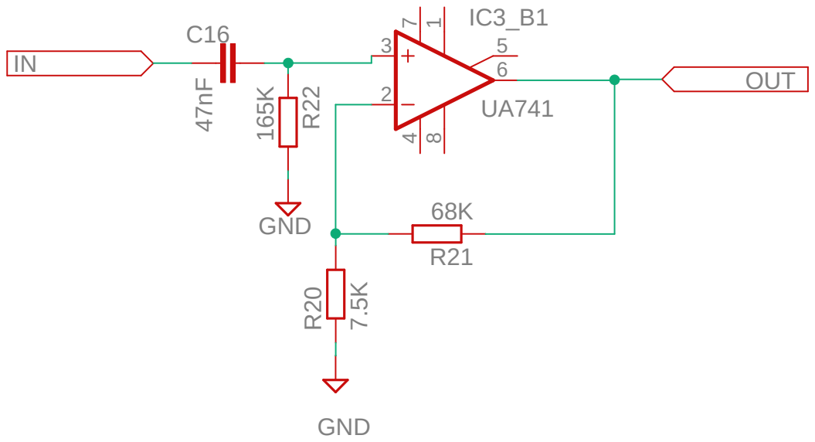
[picture p26: figure]
GND ¹⁶⁵K 47nF; GND; OUT; IC3_B1 R²⁰; R21 R²²

Figura 3.14: Schema del filtro attivo passa alto del primo ordine

In Figura 3.15 si pu`o notare come il filtro teorico (mostrato in blu) e quello sperimentale (mostrato in rosso) abbiano un andamento simile, ma non siano sovrapposti. Il filtro sperimentale rispetta la specifica di progetto del limite inferiore di banda passante di 20Hz. Possiamo dire che il filtro attenua il segnale con frequenze inferiori a 1Hz in quanto si trova ad un valore di -20dB. Per quanto riguarda le frequenze comprese tra 1Hz e 20Hz `e vero dire che risultano amplificate, ma di un valore inferiore rispetto alla banda passante del filtro. Questo non risulta essere un problema poich´e i due stadi precedenti, LP4 e il mixer, attenuano il prodotto delle sinusoidi in ingresso al filtro di un valore 20. Pertanto le armoniche fuori dalla banda passante del filtro passa alto risultano comunque attenuate. Il risultato finale `e riportato in Figura 3.18.

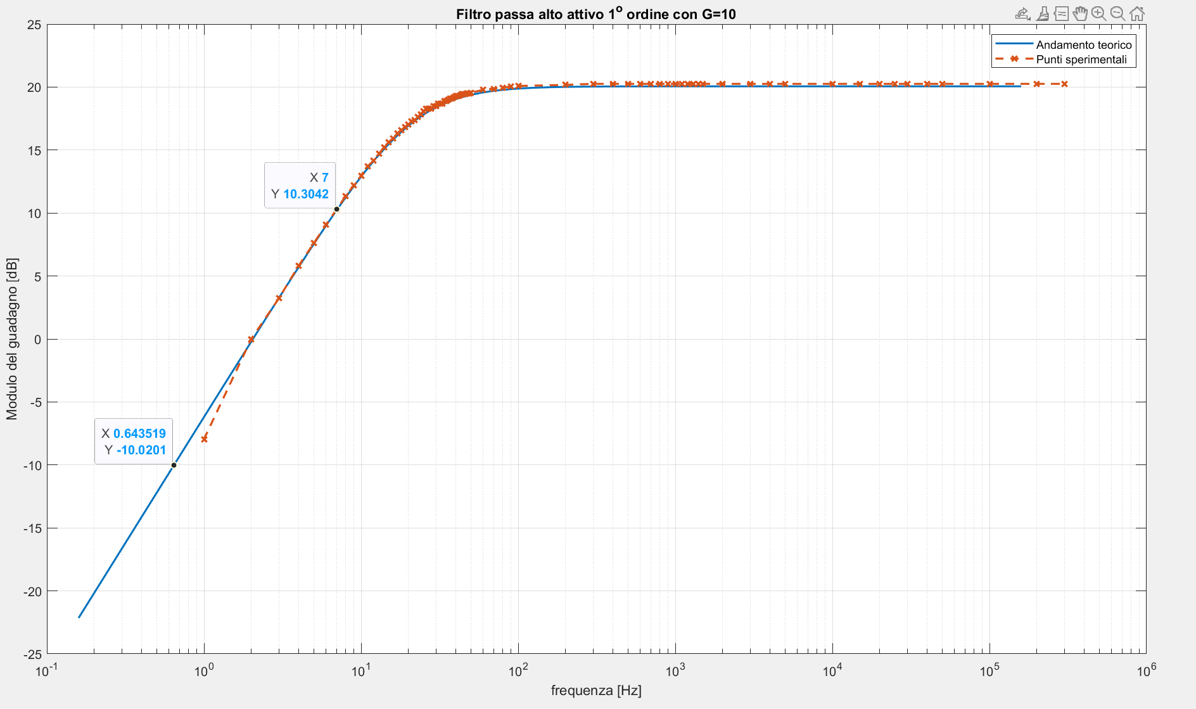
[picture p27: figure]

Figura 3.15: Diagramma di Bode del filtro passa alto del 1o ordine

### 3.6 Theremin

In Figura 3.16 `e riportato lo schema circuitale completo del Theremin. Si possono osservare i vari blocchi introdotti nei capitoli precendenti e come vengono posti in relazione tra loro.

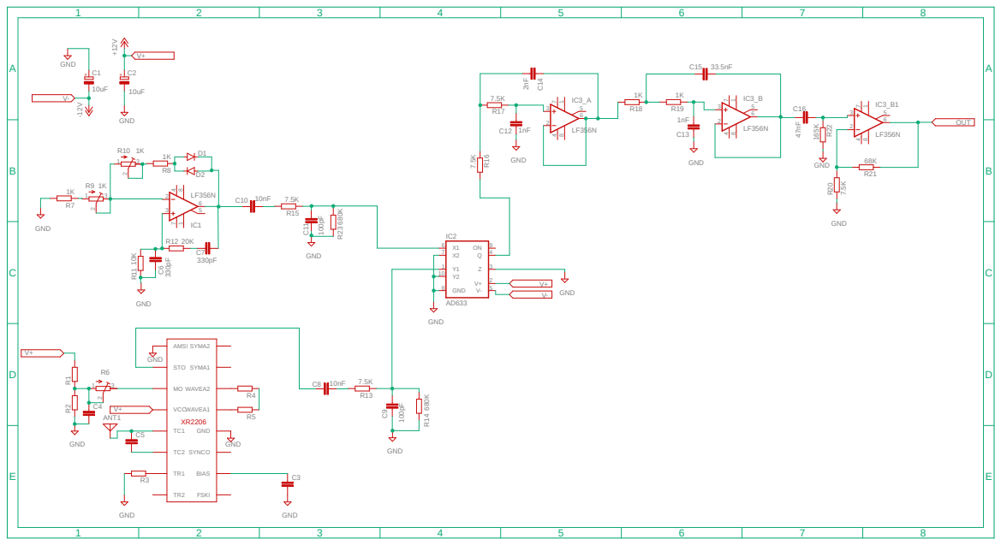
[picture p28: figure]
GND; GND ⁺¹²V -12V; 1nF ²nF; GND ¹⁶⁵K 47nF; OUT 680K; AMSI; STO; VCC; FSKI; BIAS; SYNCO; WAVEA1; WAVEA2; SYMA1; SYMA2; ANT1 R¹ R²; GND 8; R¹⁴; R15 C¹¹; R8 R¹¹; IC3_B R¹⁶; C13 C¹⁴; IC3_B1 R²⁰; R21 R²²; C16 R²³

Figura 3.16: Schematico completo del circuito realizzato

La scelta delle frequenze operative nell’ordine del centinaio di kHz `e stata obbligata per poter avere una risoluzione accettabile in frequenza avvicinando la mano alla capacit`a variabile collegata al VCO. Come si `e visto nelle sezioni precedenti e come `e riportato nella Figura 3.7 e in Figura 3.4.
Necessario `e stato l’inserimento del filtro passa basso del quarto ordine in cascata al mixer. Questo ha portato ad un notevole miglioramento del THD del segnale in uscita, come mostra la FFT riportata in Figura 3.17, nella quale si pu`o notare la presenza di una singola armonica. L’oscilloscopio utilizzato non ha permesso di rilevare altre armoniche con la scala impostata, quindi non `e stato possibile valutare il THD del segnale.

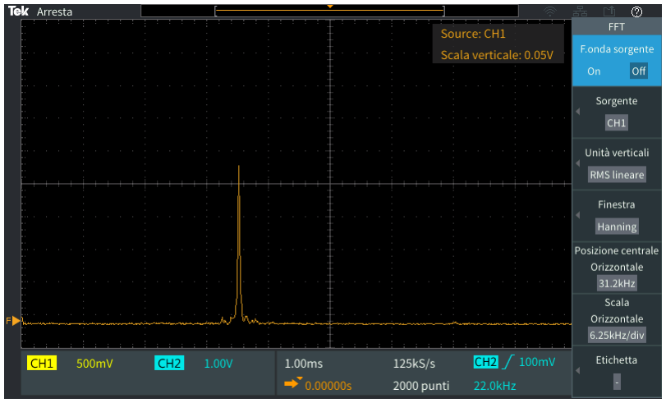
[picture p29: figure]

Figura 3.17: FFT in uscita dall’AD633 dopo il Filtro passa basso del quarto ordine

L’aggiunta del filtro attivo passa alto `e stato introdotto per tagliare la componente continua e le armoniche inferiori ai 20Hz. In Figura 3.18 `e possibile osservare l’uscita complessiva del sistema.

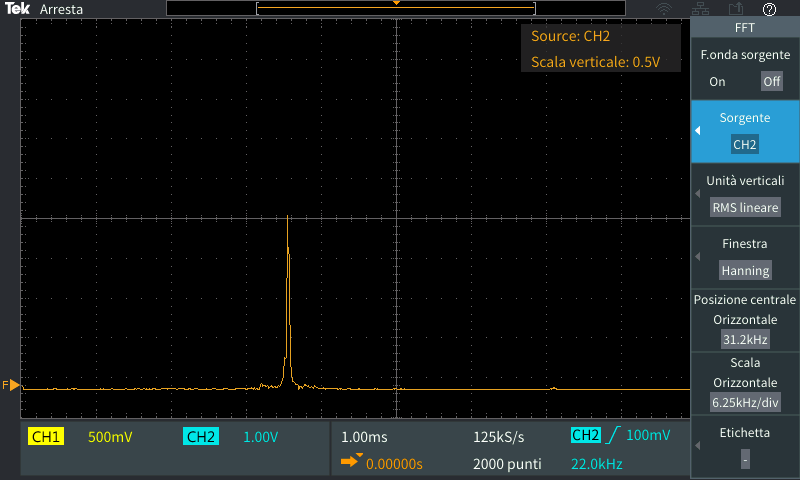
[picture p30: figure]

Figura 3.18: FFT della sinusoide in uscita dal sistema

E importante notare come in relazione alla ` | Figura 3.17 l’introduzione del filtro passa alto
non abbia portato un miglioramento apprezzabile al sistema. Tuttavia si pu`o notare che la sinusioide in in uscita al filtro passa basso del quarto ordine, indicata in colore giallo, abbia delle componenti in alta frequenza evienziate dagli spikes che si vedono sovrapposti alla sinusoide principale. Tali spikes, vengono eliminati dallo stadio successivo, ovvero il passa alto attivo. Questo accade perch`e il passa alto `e stato realizzato utilizzando l’amplificatore operazione UA741. Questo tipo di operazionale ha un rapporto guadagno banda (GBP) che cala la banda passante in relazione al guadagno impostato dall’amplificatore, come spiegato nella Sezione

1.1. Questo componente dunque agisce da filtro passa basso per costruzione. Uilizzandolo per realizzare un filtro passa alto attivo si ottiene un filtro passa banda, come somma dei due effetti, che va selezionare una banda passante di frequenze non attenuate.

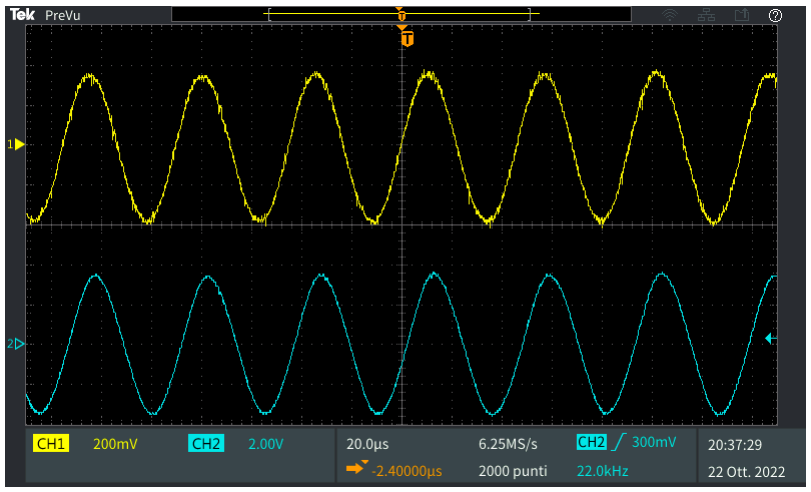
[picture p31: figure]

Figura 3.19: Sinusoidi in uscita dall’AD633 senza e con il filtro passa alto

La variazione di frequenza si manifesta con l’avvicinamento o l’allontanamento della mano dell’utente dalla bandiera, che compone l’altra faccia della capacit`a variabile. La variazione di capacit`a determinata dalla posizione della mano determina quindi la variazione di frequenza. In origine avevamo deciso di utilizzare una frequenza di riferimento di 45kHz per poi variare il segnale generato dal VCO a frequenza che andassero da circa 45kHz a circa 45kHz. Tuttavia, `e stato immediatamente riscontrato il problema della sensibilit`a, ovvero si `e osservato come le uniche variazioni di frequenza apprezzabili si ottenessero quando la mano era posta a contatto con l’antenna o se quest’ultima fosse completamente assente. Si riusciva dunque a coprire una piccolissima parte del range richiesto dal progetto senza per`o ottenere le variazioni volute. Perci`o, si `e deciso di alzare le frequenze operative, portando il riferimento in uscita dall’oscillatore di Wien ad un valore di 245kHz come mostrato in Figura 3.6. Questo ha porta a dover aumentare anche il range di frequenze del VCO portando cos`ı gli estremi da un’oscillazione di 275kHz senza la presenza della mano a circa 250kHz con la presenza della mano ad una distanza minima ove la mano risultasse quasi a contatto con l’antenna. In questo caso, si `e riscontrato un netto miglioramento della sensibilit`a nella variazione della frequenza rispetto alla distanza della mano. Nella Tabella 3.4 sono mostrati i risultati sperimentali ottenuti misurando la frequenza di oscillazione del segnale di uscita in relazione alla distanza della mano dalla bandiera.

Dalla tabella 3.4 si `e calcolato la sensibilit`a relativa del sistema completo al variare della distanza della mano dall’antenna.
In figura 3.20 vengono mostrati i punti ottenuti sperimentalmente e una curva ottenuta con un’approssimazione ai minimi quadrati utilizzando un polinomio di grado 3. Dalla figura `e possibile osservare come la sensibilit`a sia molto elevata per distanze mano-antenna molto piccole, mentre sia pressoch´e nulla quando la mano supera gli 8 cm di distanza dall’antenna.

Distanza [cm] | Frequenza [kHz]
15 | 272
14 | 272
13 | 273
12 | 273
11 | 272
10 | 272
9 | 272
8 | 271
7 | 269
6 | 270
5 | 267
4 | 265
3 | 260
2 | 259
1 | 249
0 | 244

Tabella 3.4: Relazione distanza della mano dell’utente dall’antenna - frequenza di oscillazione della sinusoide prodotta

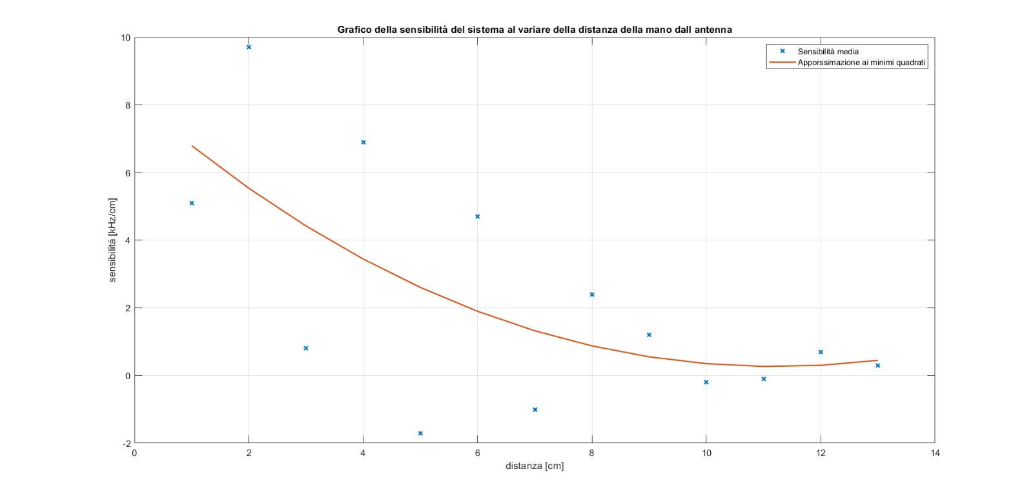
[picture p32: figure]

Figura 3.20: Sensibilit`a del sistema

# Capitolo 4

# Conclusioni

In conclusione, il circuito realizzato rispetta le specifiche di progetto, in quanto testando con un generatore di funzione i filtri, in uscita essi garantiscono il passaggio di sinusoidi con frequenza compresa tra 20Hz e 20kHz. Osservando la Tabella 3.4 si pu`o osservare che i limiti inferiore e superiore concordano con la scelta di un oscillazione di 245kHz per l’oscillatore di Wien. Infatti, l’uscita complessiva del sistema oscilla tra 22kHz in assenza della mano, fino a 1kHz quando la mano `e in prossimit`a dell’antenna. Il risultato non `e ottimo ma abbastanza soddisfacente visti i limiti fisici dovuti agli strumenti a disposizione. Infatti, il limite inferiore di oscillazione del sistema `e dovuto soltato ai disturbi generati dall’antenna quando la mano `e molto vicina (circa 2cm di distanza). Le frequenze nell’ordine delle centinaia di kHz permettono di avere delle variazioni apprezzabili sulla frequenza in uscita al sistema. Ovvero la riduzione della frequenza della sinusoide risulta proporzionale alla distanza della mano dall’antenna. Non sono stati imposti vincoli sulla risoluzione, principale tallone d’Achille del sistema realizzato. La risoluzione infatti non risulta costante, inoltre man mano ci si avvicina con la mano all’antenna il sistema risulta meno sensibile. Infatti, non `e possibile rilevare variazioni inferiori al kHz. Il problema della risoluzione potrebbe essere risolto migliorando il sistema utilizzato per la realizzazione della capacit`a variabile. Inoltre, aumentando la frequenza di oscillazione dell’XR2206 `e possibile ottenere una sensibilit`a maggiore poich´e per aumentare la frequenza di oscillazione `e necessario utilizzare capacit`a molto piccole (dell’ordine del pF) confrontabili con la capacit`a formata tra antenna e mano. Questo fa in modo di attuare una variazione di capacit`a molto incisiva per la generazione del segnale, il quale avr`a una risoluzione maggiore.

# Elenco delle figure

1 | Schema generale di funzionamento di un circuito per la realizzazione di un tono. | 2
2 | Schema a blocchi generale del progetto | | 2
1.1 PinOut dei tre Amplificatori Operazionali usati | | 4
1.2 Schema a blocchi dell’oscillatore monolitico XR2206 | | 5
1.3 Banda passante del moltiplicatore analogico AD633 | | 5
1.4 PinOut e schema a blocchi dell’AD633 | | 6
2.1 Schema a blocchi del sistema realizzato | | 7
2.2 Schema a blocchi interno dell’oscillatore monolitico XR2206 | | 8
2.3 Schema generale di un oscillatore a ponte di Wien auto-avviante. A sinistra lo
| schema utilizzato per il progetto | | 9
2.4 FFT della sinusoide a 295kHz in uscita dall’oscillatore acquisita tramite oscillo-
scopio | 10
2.5 FFT del segnale in uscita dall’AD633, con test tra Oscillatore di Wien avente ω0
= 45kHz 12V picco e generatore di funzione con segnale 20 Khz e 2.5V picco. . . 12
2.6 Filtro attivo di ordine 4 | 13
2.7 Diagramma di Bode del modulo del filtro | 13
2.8 Schematico del filtro passa alto attio del primo ordine, con guadagno per com-
| pensare l’attenuazioen itordotta dal mixer. Posto in uscita dal filtro passa basso
del quarto ordine | 14
2.9 Schematico del filtro passa banda passivo meso in uscita dal XR2206 e in uscita
all’oscillatore riportato nella sezione 2.2 | 15
2.10 Diagramma di Bode del filtro passa banda passivo con evidenziati il polo e gli zeri. 15
3.1 Foto dell’antenna utilizzata come capacit`a variabile | 16
3.2 Confronto tra i segnali in uscita dall’oscillatore monolitico XR2206 prima (in
bianco) e dopo (in giallo) il fitro LP in cascata | 17
3.3 Segnale in uscita dal blocco XR2206 + LP | 17
3.4 Confronto tra le FFT del segnale in uscita dall’oscillatore monolitico XR2206
prima e dopo il filtro LP in cascata | 18
3.5 Schematico dell’oscillatore di Wien utilizzato | 19
3.6 Confronto tra i segnali in uscita dall’oscillatore di Wien prima e dopo il fitro BP
in cascata | 20
3.7 Confronto tra le FFT del segnale in uscita dall’oscillatore di Wien prima e dopo
il filtro BP in cascata | 21
3.8 FFT in uscita dal mixer AD633 senza filtraggio | 22
3.9 Armoniche coinvolte nella sovrapposizione messe in evidenza | 23
3.10 Diagrammi di bode del componente LF353P in anello aperto | 24
3.11 Diagramma di Bode del filtro Sallen-Key del 4o ordine | 24
3.12 Diagramma di Bode delle celle Sallen-Key del 2o ordine, che compongono il filtro
del 4o ordine | 25

3.13 Ampiezza massima del segnale di uscita in relazione alla sua frequenza | 26
3.14 Schema del filtro attivo passa alto del primo ordine | 27
3.15 Diagramma di Bode del filtro passa alto del 1o ordine | 28
3.16 Schematico completo del circuito realizzato | 29
3.17 FFT in uscita dall’AD633 dopo il Filtro passa basso del quarto ordine | 30
3.18 FFT della sinusoide in uscita dal sistema | 30
3.19 Sinusoidi in uscita dall’AD633 senza e con il filtro passa alto | 31
3.20 Sensibilit`a del sistema | 32

# Elenco delle tabelle

3.1 Misure in ampiezza delle componenti armoniche e calcolo del THD della sinusoide
in scita dall’XR2206 filtrata dal filtro passa-banda | 18
3.2 Ampiezza delle armoniche del segnale in uscita dall’oscillatore di Wien | 21
3.3 Ampiezze delle armoniche del segnale filtrato con il filtro passa basso in cascata
all’oscillatore di Wien | 21
3.4 Relazione distanza della mano dell’utente dall’antenna - frequenza di oscillazione
della sinusoide prodotta | 32
