LucaBrescia/theremin-psea/Immagini/sch_hp1_no_valori.pdf

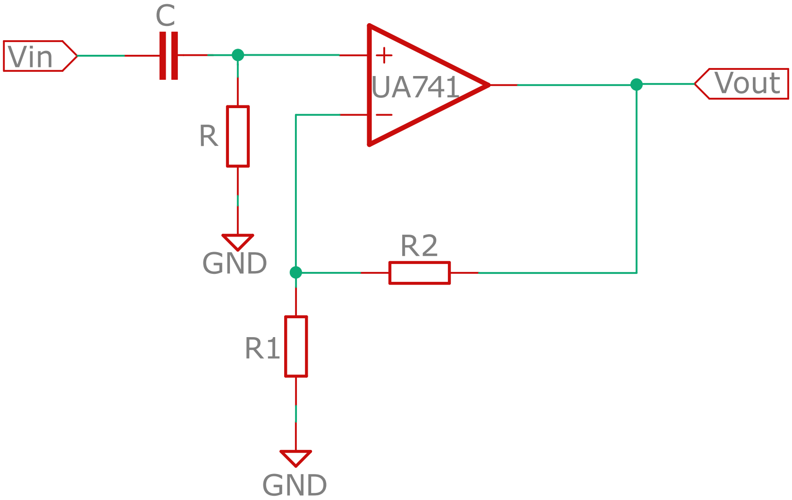
[picture p33: figure]
GND; Vin; Vout
