LucaBrescia/theremin-psea/Immagini/sch_hp1.pdf

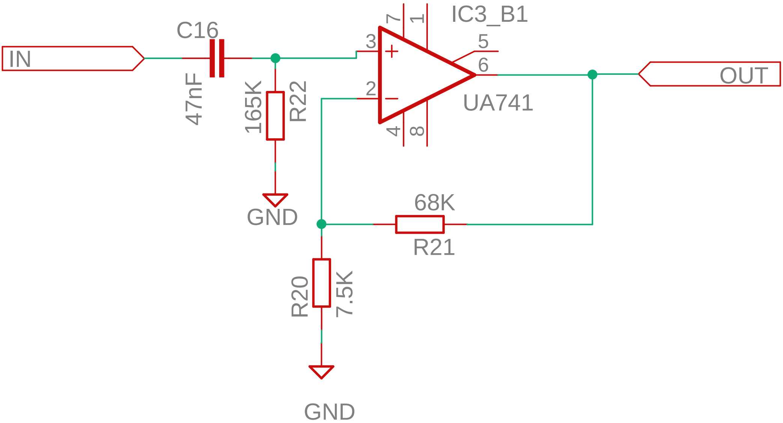
[picture p34: figure]
GND ¹⁶⁵K 47nF; GND; OUT; IC3_B1 R²⁰; R21 R²²
