LucaBrescia/theremin-psea/Immagini/ad633_bp.pdf

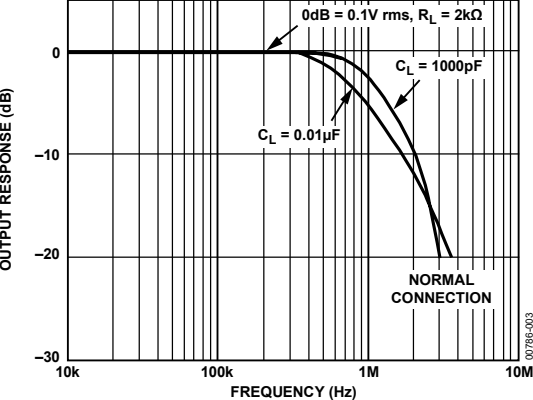
[picture p35: figure]
FREQUENCY (Hz); OUTPUT RESPONSE (dB); 10M⁰⁰⁷⁸⁶⁻⁰⁰³; NORMAL CONNECTION; 0dB = 0.1V rms, RL
