LucaBrescia/theremin-psea/Immagini/lf353n_pinout.pdf

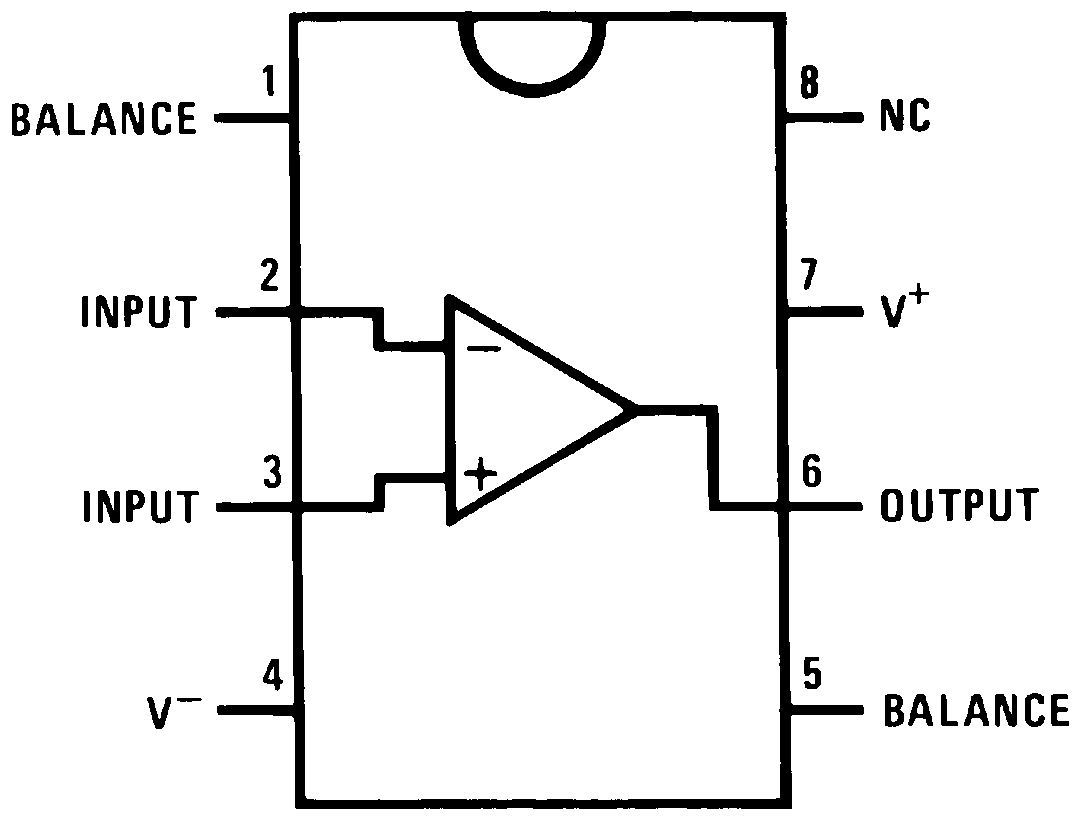
[picture p50: page 1]
