LucaBrescia/theremin-psea/Immagini/ua741_pinout.pdf

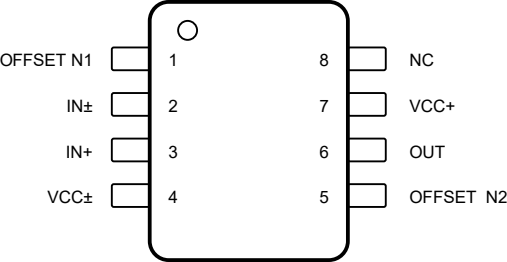
[picture p51: figure]
OFFSET N1; VCC+; OUT; 4VCC±; OFFSET N2
