LucaBrescia/theremin-psea/Immagini/lf356p_pinout.pdf

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
1OUT
1IN–
1IN+
VCC –

VCC +
2OUT
2IN–
2IN+
