LucaBrescia/theremin-psea/Immagini/bode_filtro_passa_banda_matlab.pdf

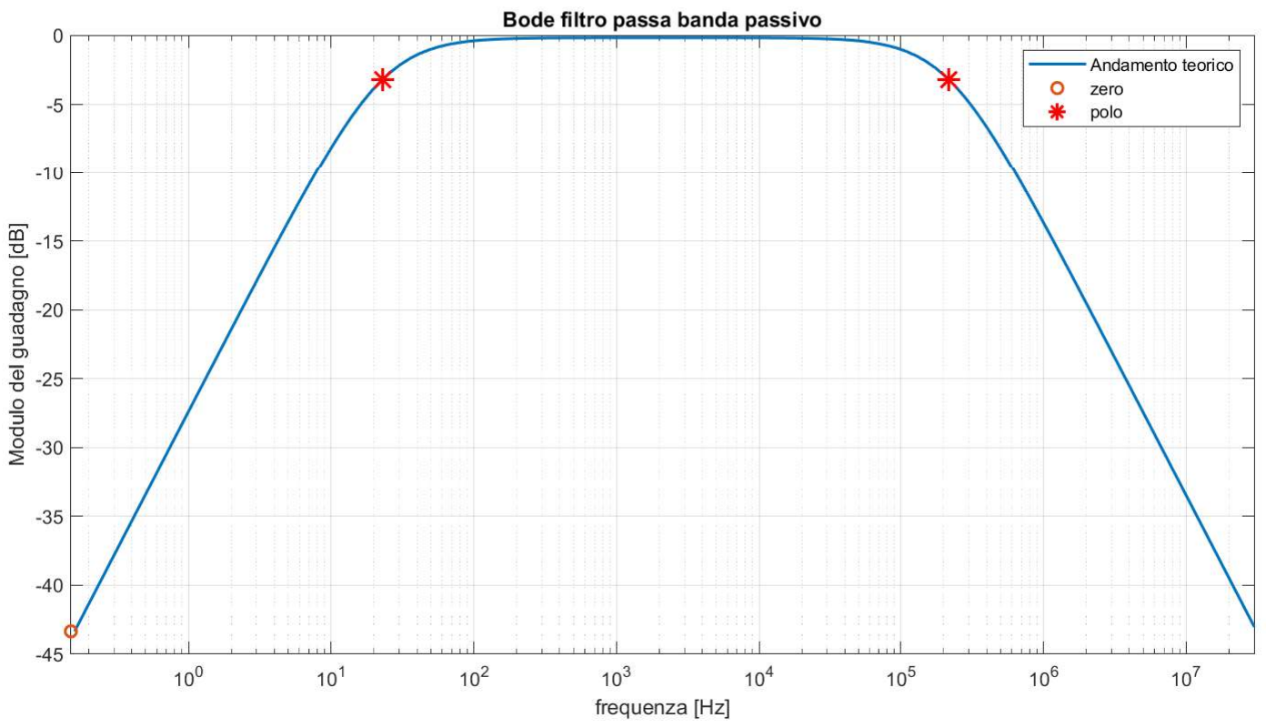
[picture p52: page 1]
