LucaBrescia/theremin-psea/Immagini/bode_lp4.pdf

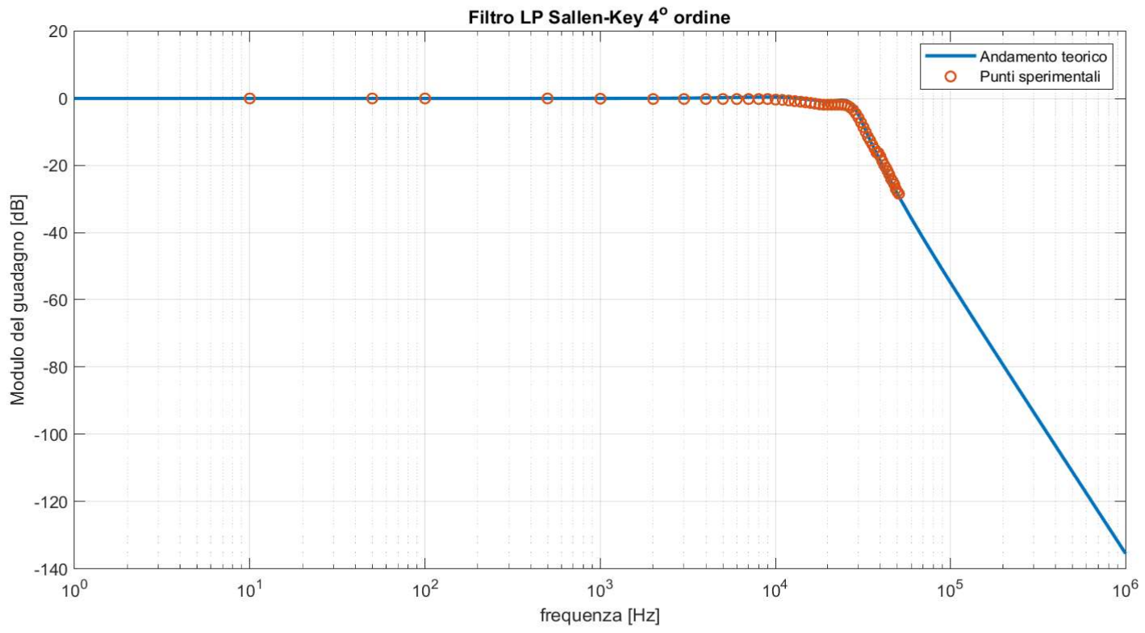
[picture p53: page 1]
