LucaBrescia/theremin-psea/Immagini/hpf1_filter_response.pdf

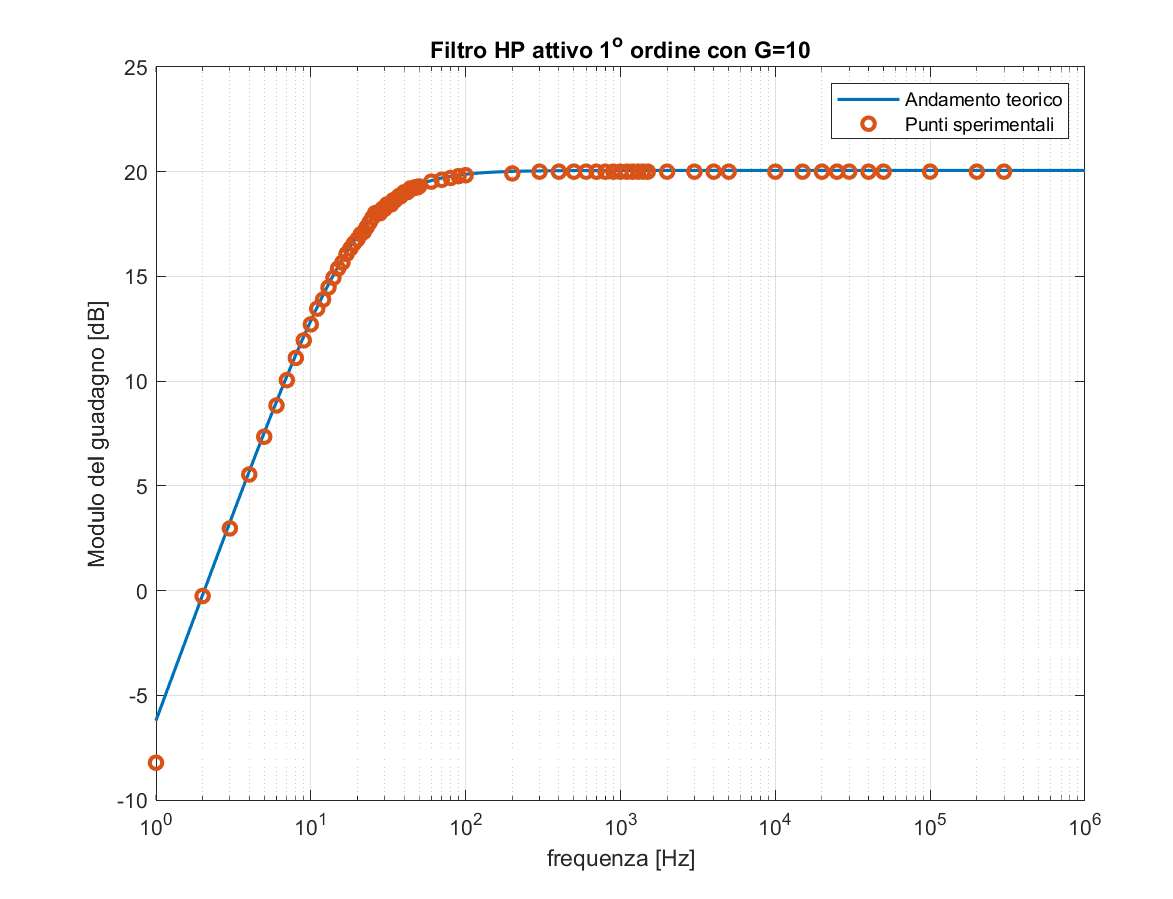
[picture p54: page 1]
