LucaBrescia/theremin-psea/Immagini/hpf1_psea.pdf

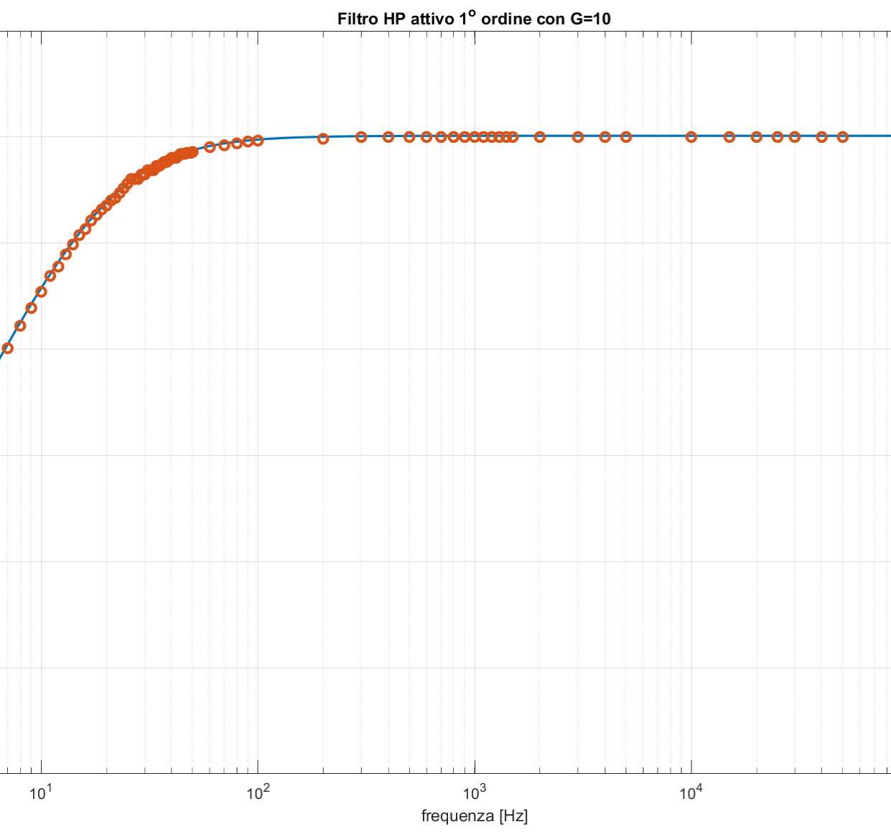
[picture p55: page 1]
