LucaBrescia/theremin-psea/Immagini/zoom_lp4.pdf

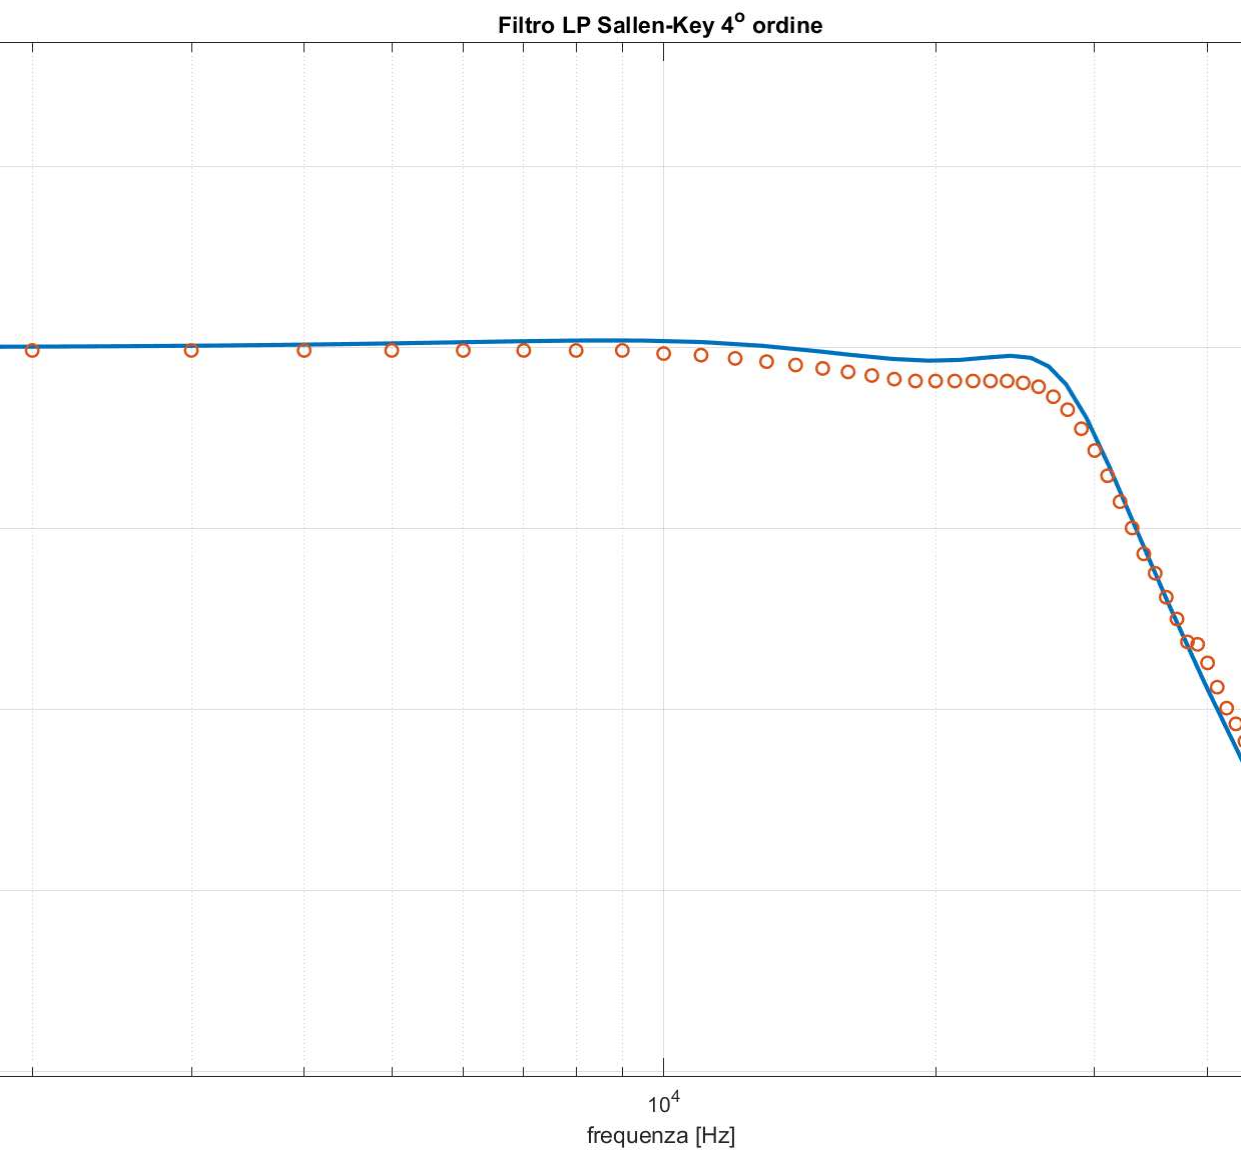
[picture p56: page 1]
