LucaBrescia/theremin-psea/Immagini/Ponte di wien giusto.pdf

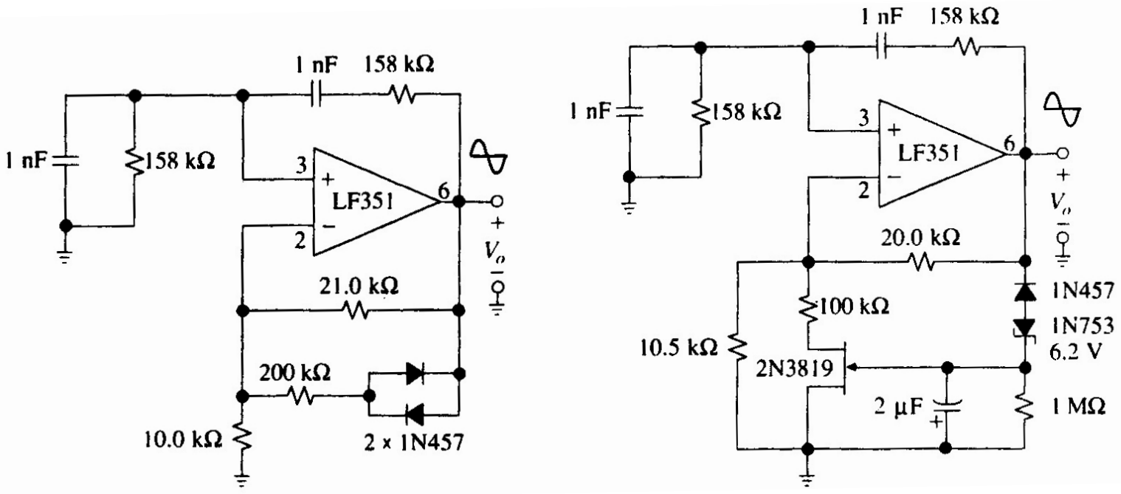
[picture p57: figure]
