LucaBrescia/theremin-psea/Immagini/bode_lp4_2.pdf

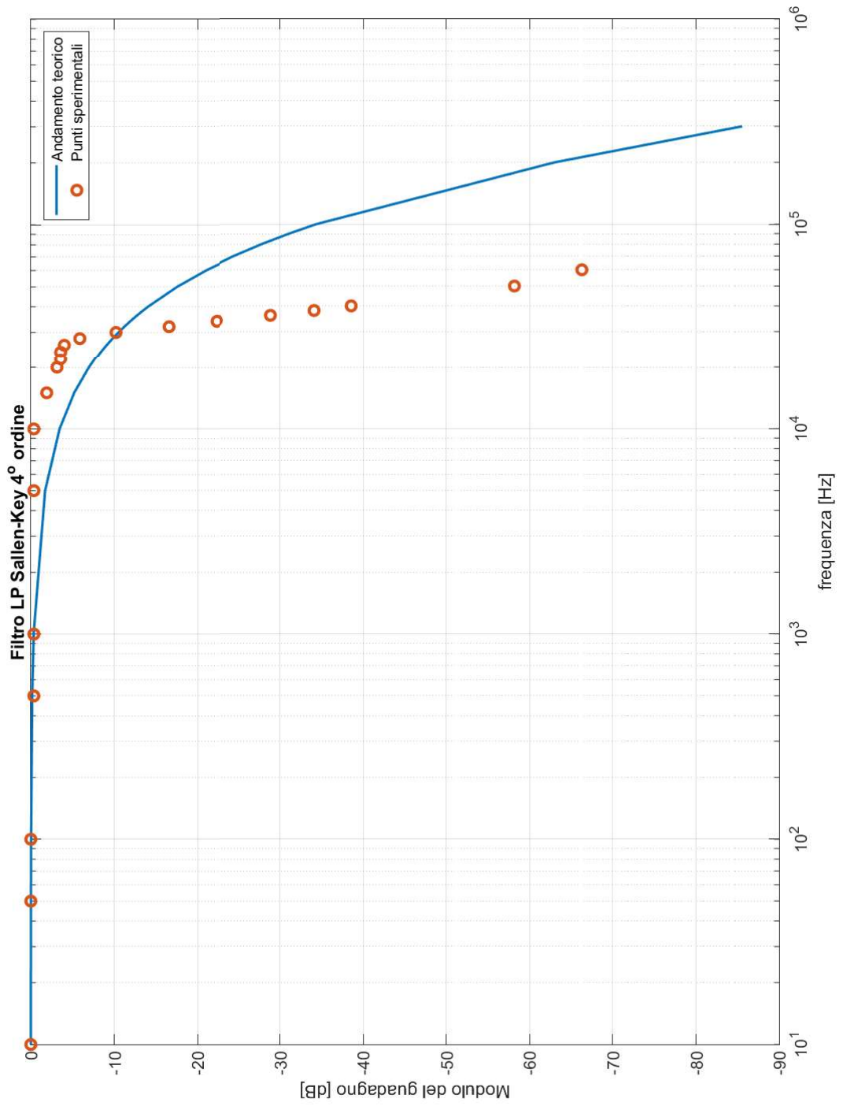
[picture p58: page 1]
