LucaBrescia/theremin-psea/Immagini/bode_lf353p.pdf

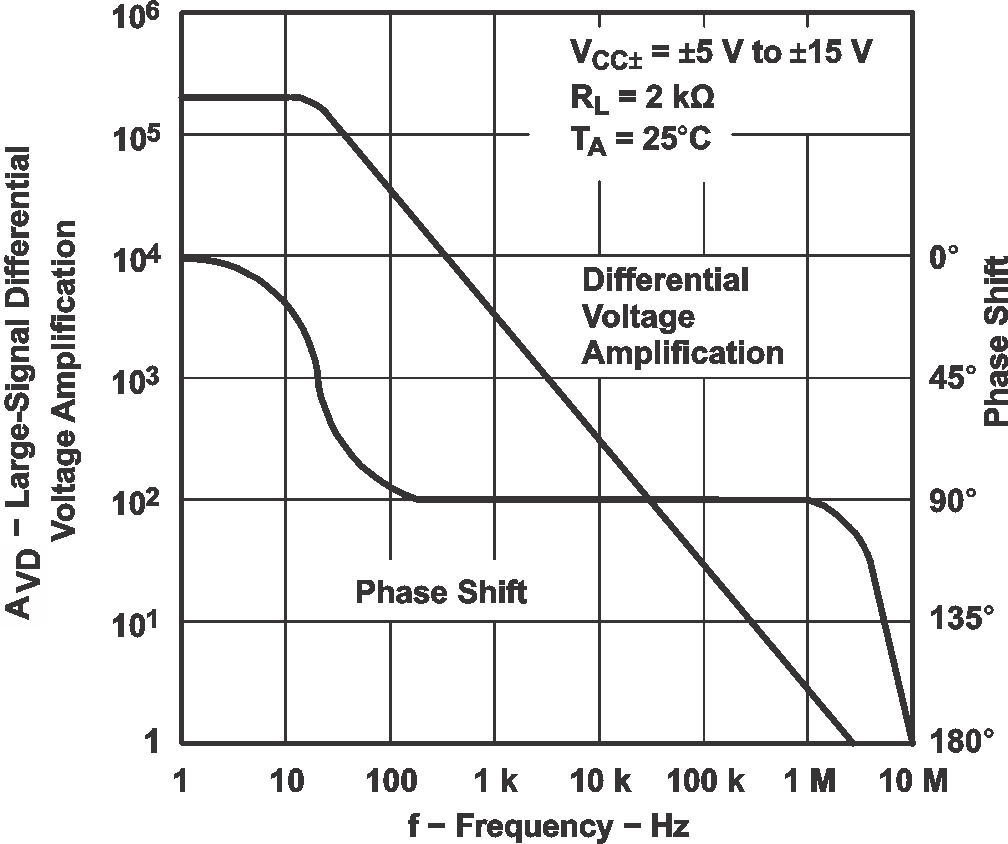
[picture p59: page 1]
