LucaBrescia/theremin-psea/Immagini/008_UscitaThereminFFT.bmp

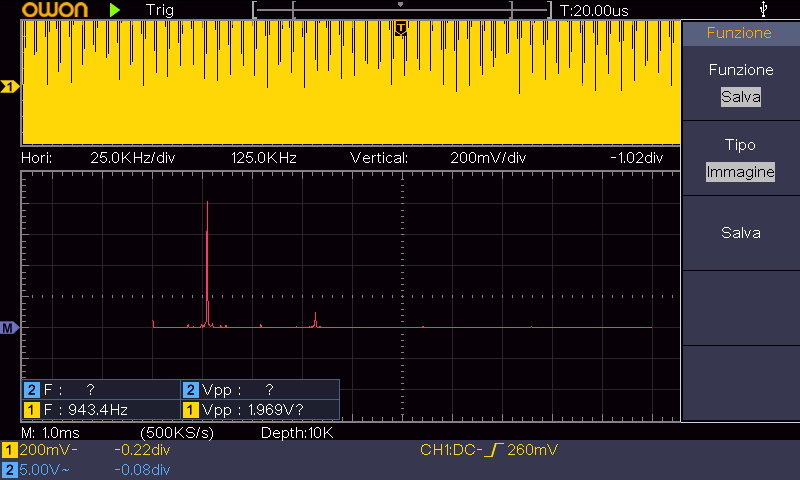
Immagini/008_UscitaThereminFFT.bmp
