LucaBrescia/theremin-psea/Immagini/010_OscillatoreWienRCFFT.bmp

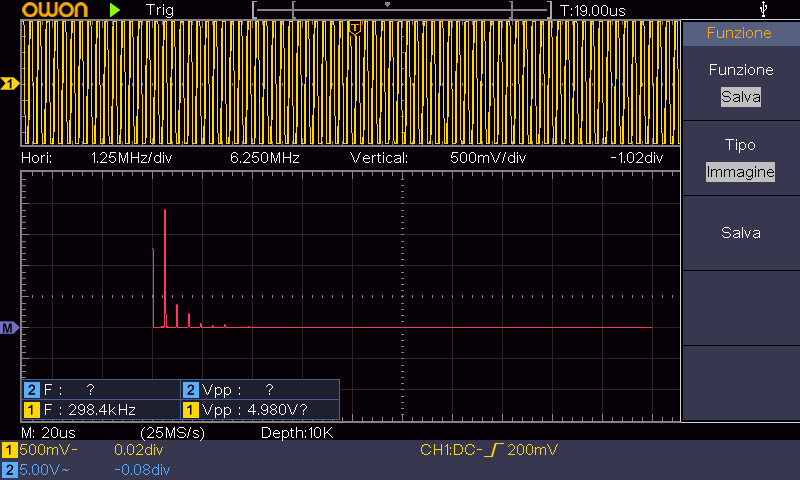
Immagini/010_OscillatoreWienRCFFT.bmp
