LucaBrescia/theremin-psea/Immagini/AD633_300k.bmp

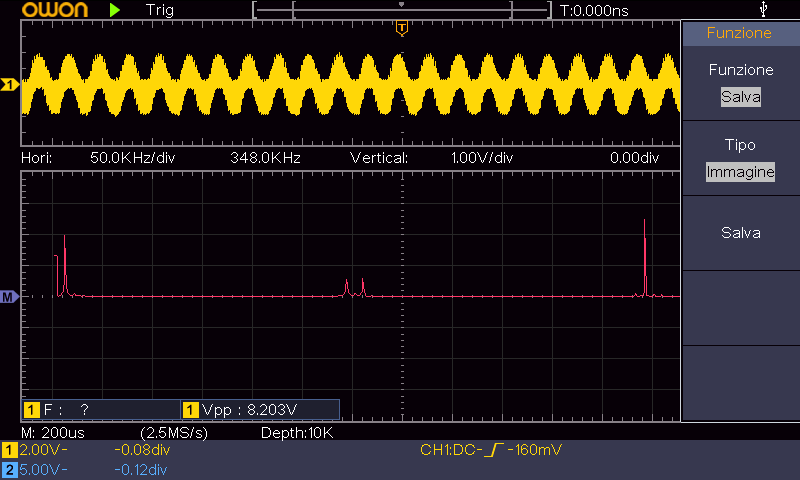
Immagini/AD633_300k.bmp
