LucaBrescia/theremin-psea/Immagini/ad663_bias_current_offset.PNG

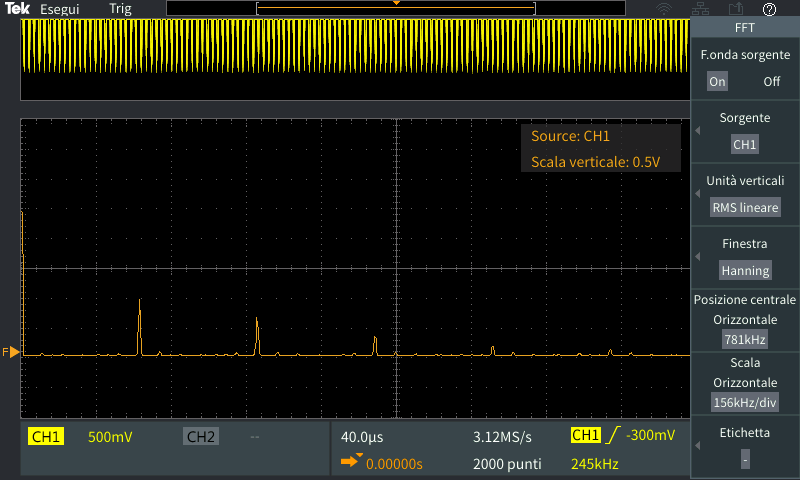
Immagini/ad663_bias_current_offset.PNG
