LucaBrescia/theremin-psea/Immagini/bmp_32_003.bmp

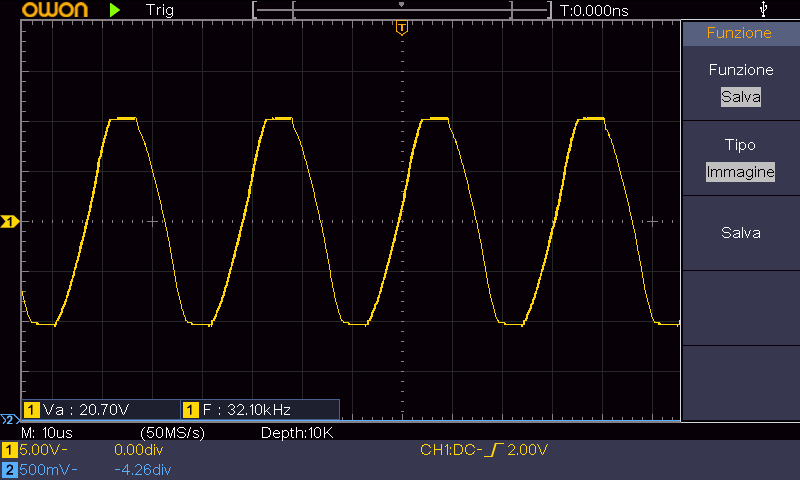
Immagini/bmp_32_003.bmp
