LucaBrescia/theremin-psea/Immagini/bmp_32_004.bmp

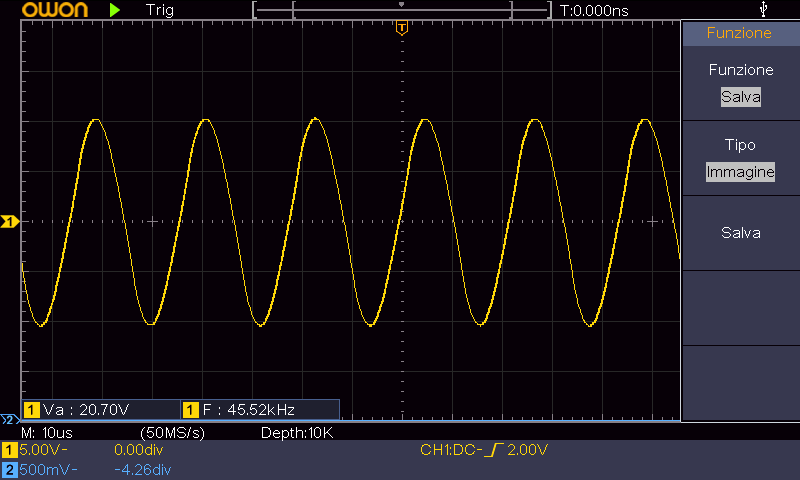
Immagini/bmp_32_004.bmp
