LucaBrescia/theremin-psea/Immagini/bmp_32_007.bmp

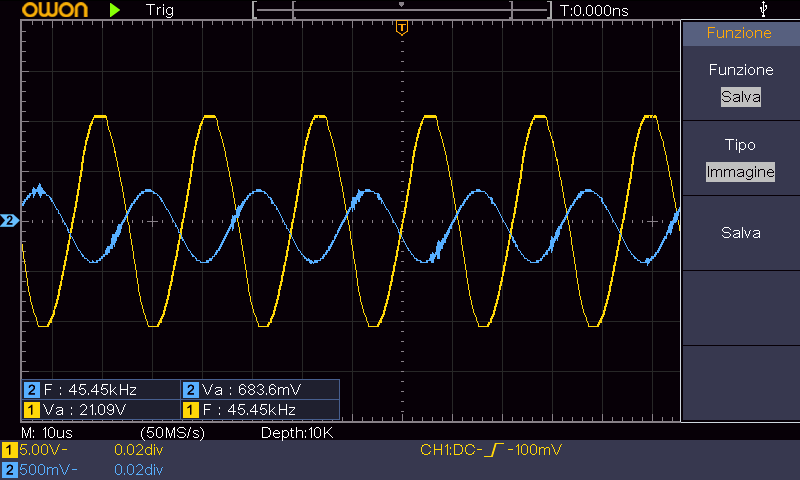
Immagini/bmp_32_007.bmp
