LucaBrescia/theremin-psea/Immagini/BODE teorico passa alto.png

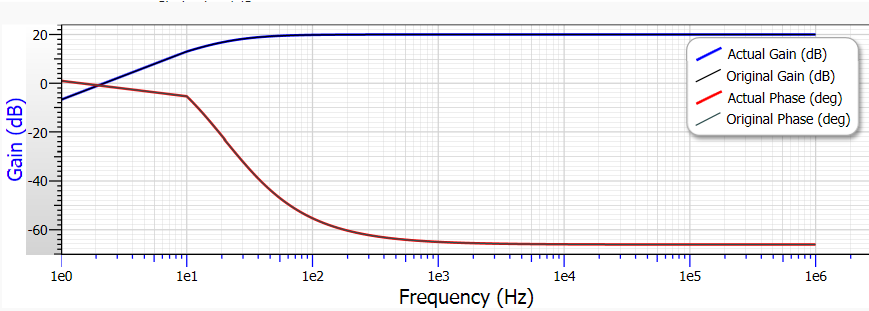
Immagini/BODE teorico passa alto.png
