LucaBrescia/theremin-psea/Immagini/circuito passa alto teorico.png

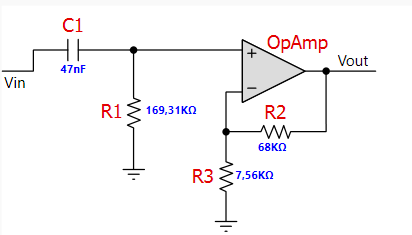
Immagini/circuito passa alto teorico.png
