LucaBrescia/theremin-psea/Immagini/FFT wien giusto bread.PNG

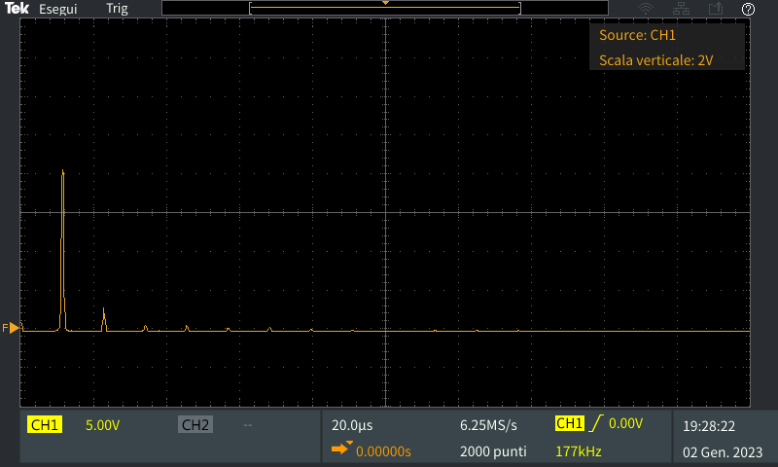
Immagini/FFT wien giusto bread.PNG
