LucaBrescia/theremin-psea/Immagini/oscillatore_riadatatto298k.bmp

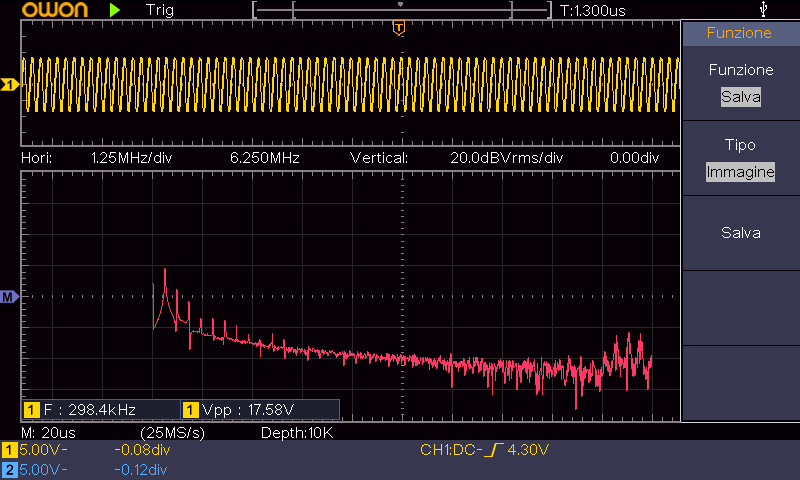
Immagini/oscillatore_riadatatto298k.bmp
