LucaBrescia/theremin-psea/Immagini/oscillatore_riadatatto298k_rms.bmp

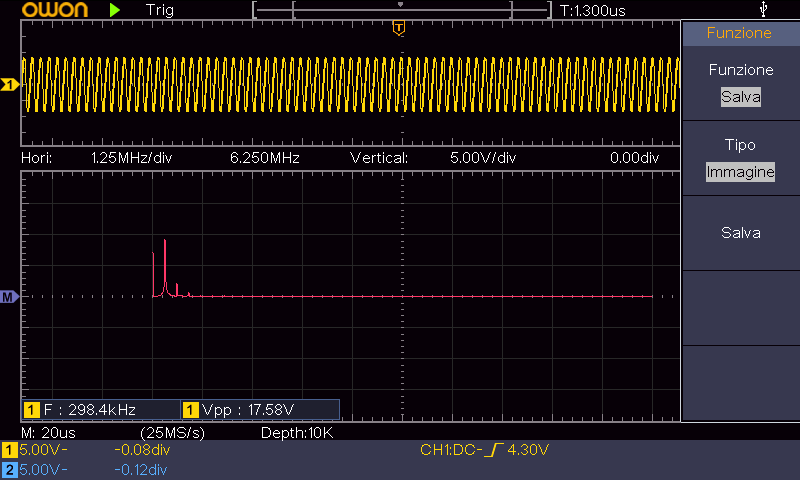
Immagini/oscillatore_riadatatto298k_rms.bmp
