LucaBrescia/theremin-psea/Immagini/sch_crc.png

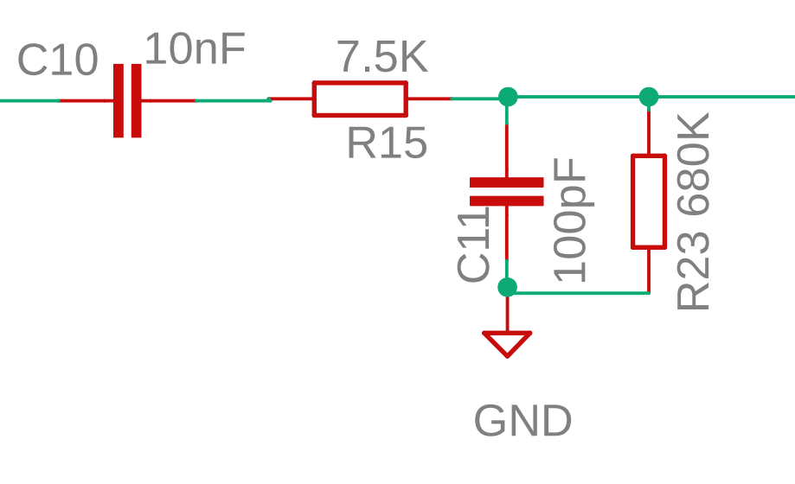
Immagini/sch_crc.png
