LucaBrescia/theremin-psea/Immagini/Schema a blocchi PSEA.png

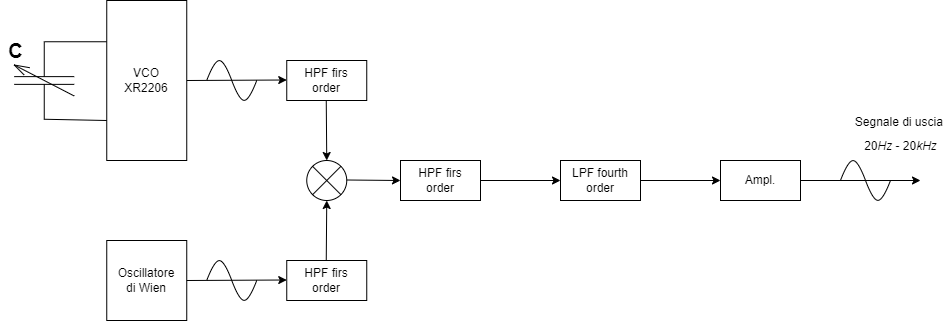
Immagini/Schema a blocchi PSEA.png
