LucaBrescia/theremin-psea/Immagini/sin_ad633_mixed.PNG

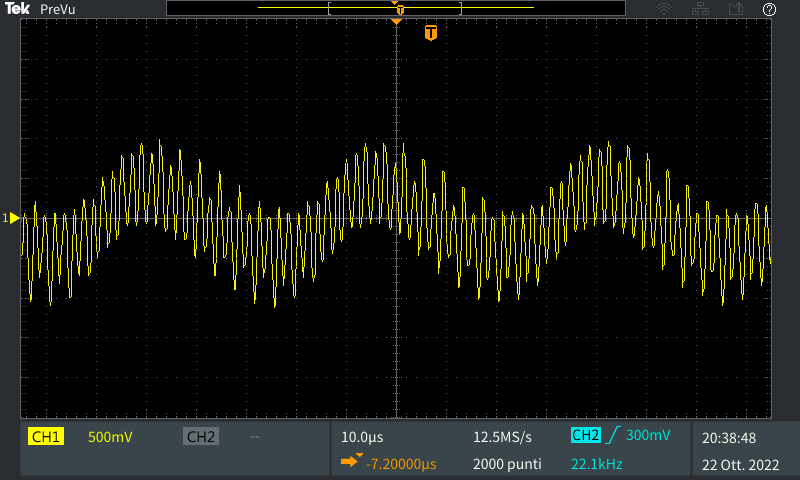
Immagini/sin_ad633_mixed.PNG
