LucaBrescia/theremin-psea/Immagini/uscita_filtro_25k_e_mux_20k.bmp

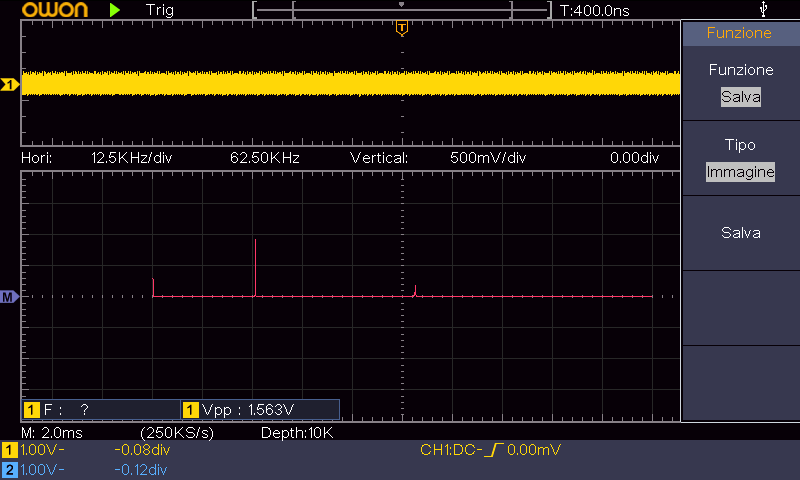
Immagini/uscita_filtro_25k_e_mux_20k.bmp
