LucaBrescia/theremin-psea/Immagini/Wien sin giusto bread.PNG

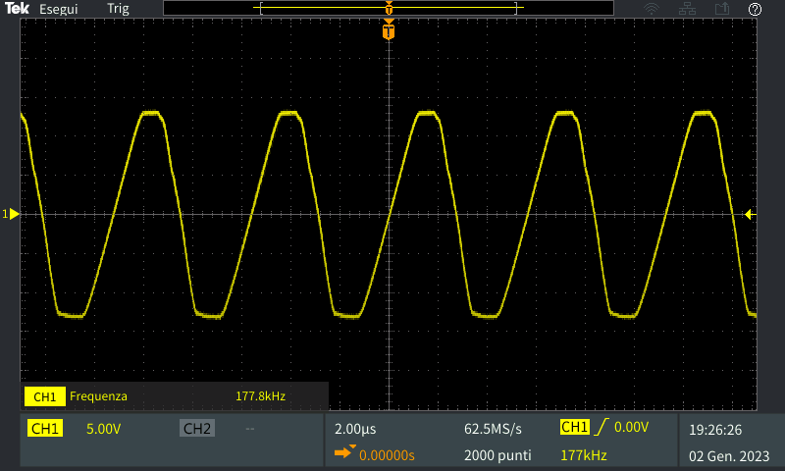
Immagini/Wien sin giusto bread.PNG
