LucaBrescia/theremin-psea/Immagini/zoom_lp4.png

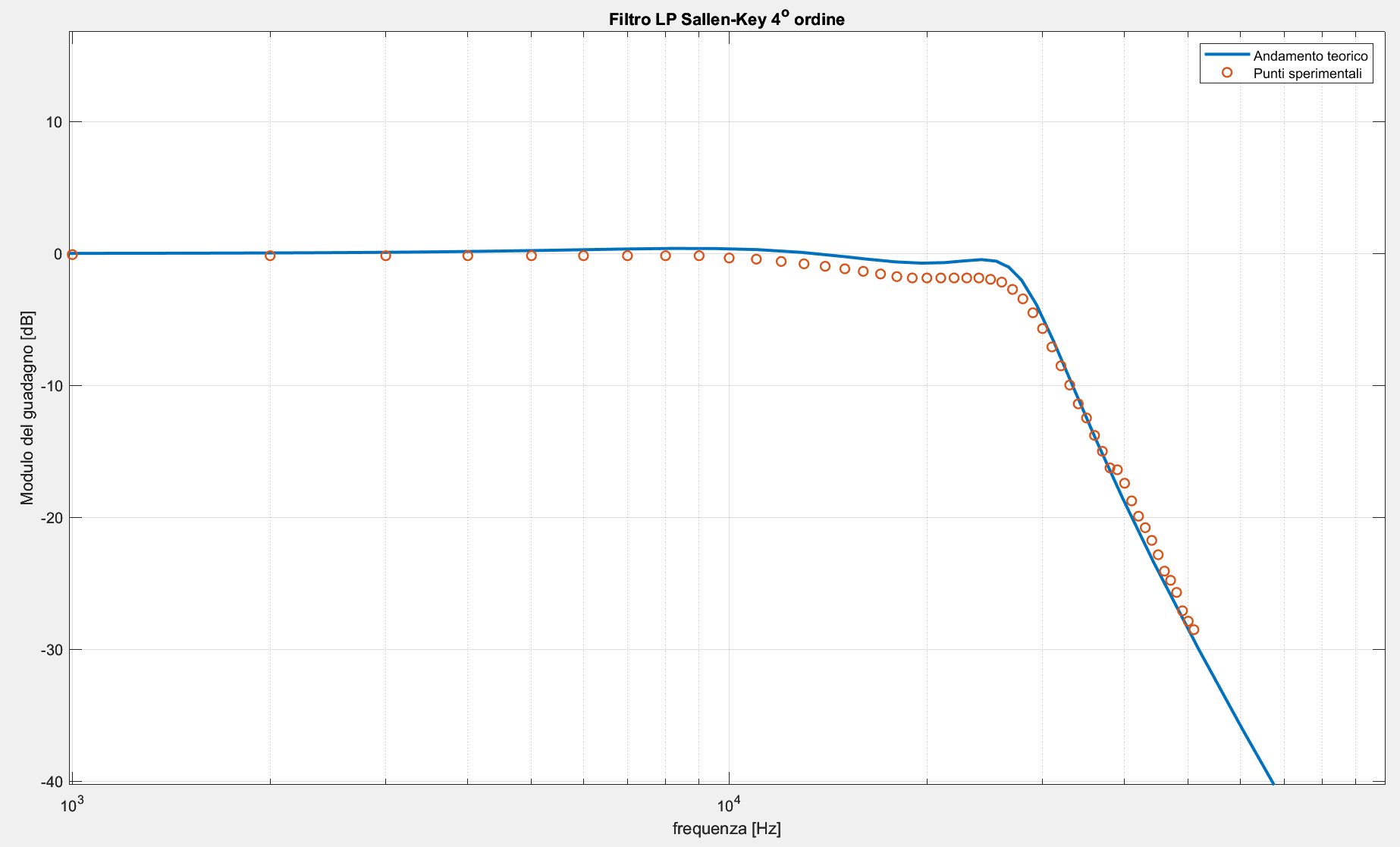
Immagini/zoom_lp4.png
