LucaBrescia/theremin-psea/Immagini/lf353n_performance.pdf

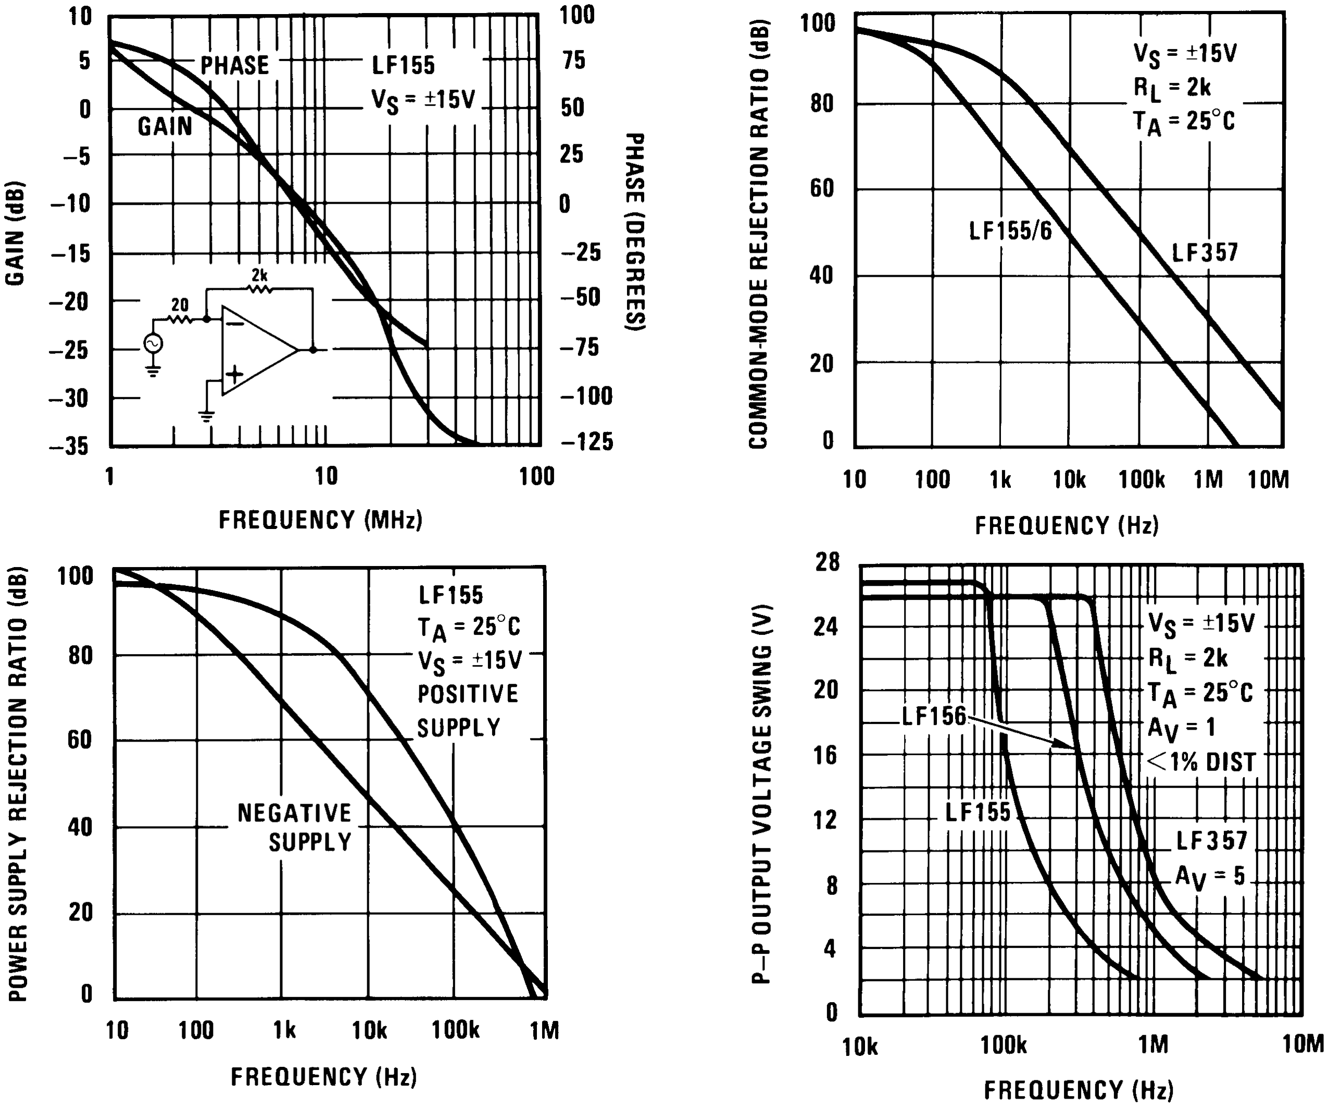
[picture p78: page 1]
