LucaBrescia/theremin-psea/Immagini/lf353p_performance.pdf

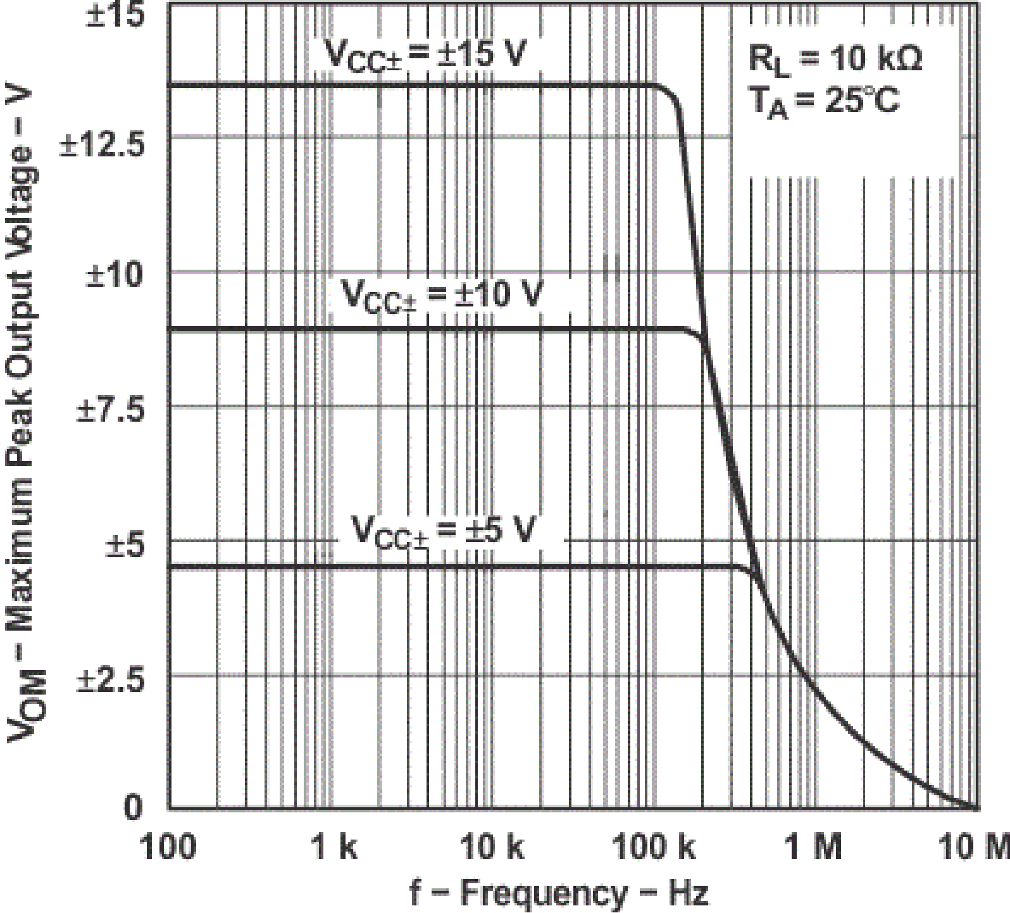
[picture p79: page 1]
