LucaBrescia/theremin-psea/Immagini/sch_complet_a4_verticale.pdf

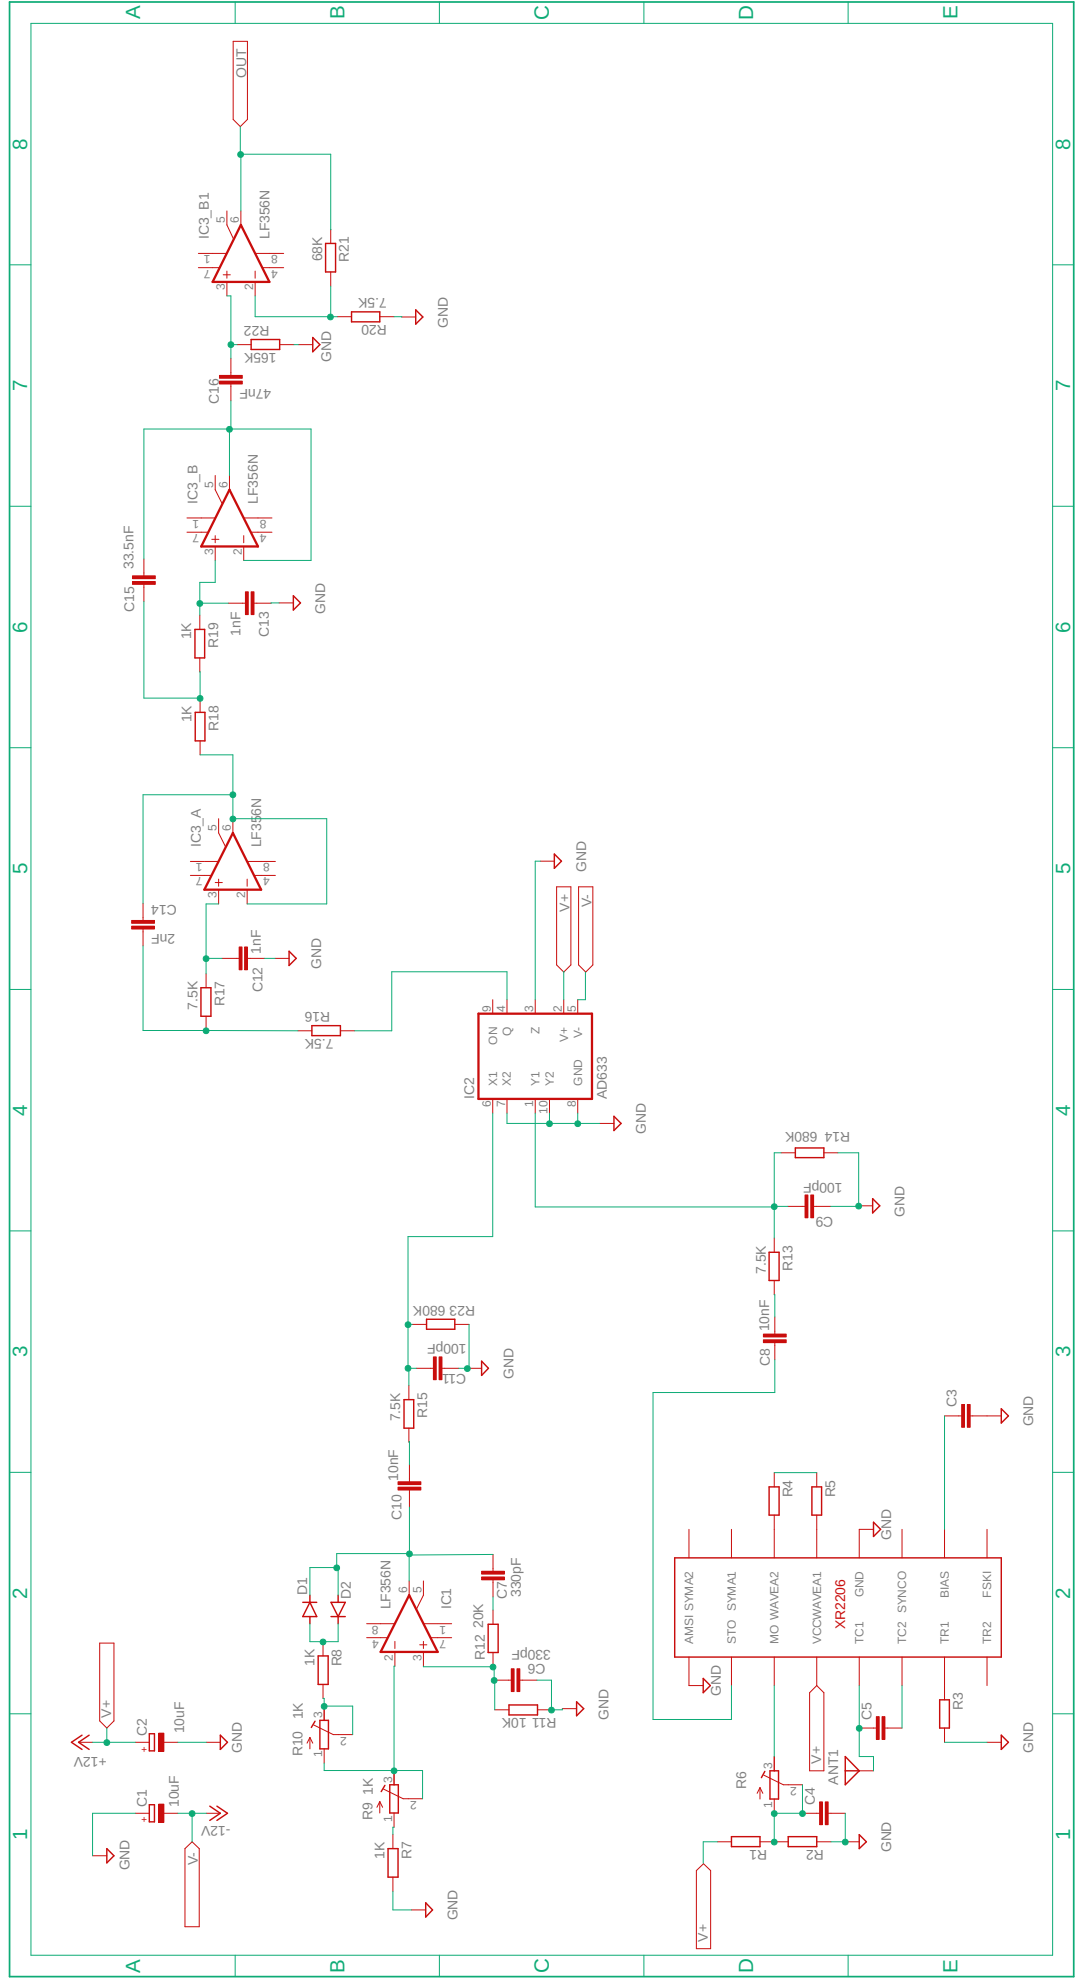
[picture p80: page 1]

7 4 IC1D1 D2 X1 6 Q 4 ON 9 Y1 1 GND 8 Z 3 X2 7 Y2 10 V+ 2 V- 5 IC2 C8 R13 C9 R14 C10 R15 C11 R7 R8 R11 R12 1 3 2 R9 1 3 2 R10 C6 C7 5 1 32 6 8 7 4 IC3_A 5 1 32 6 8 7 4 IC3_B R16 C12 R17 C13 C14 R18 R19 C15 5 1 32 6 8 7 4 IC3_B1 R20 R21 R22 C16 R23 XR2206 ++ABCDE 1 2 3 4 5 6 7 8 ABCDE 1 2 3 4 5 6 7 8

100pF GND GND GND GND 1K 1K

680K AMSI STO MOVCC TC1 TC2 TR1 TR2 FSKI BIAS SYNCO GND WAVEA2 WAVEA1 SYMA2 SYMA1 C1 C2 C4 C3 C5 ANT1 R1 R2 R3 R4 R5 1 3 R62 5 1 23 6 8

GND GND GND GND GND V+ V+
