LucaBrescia/theremin-psea/Immagini/schema_blocchi_xr2206.pdf

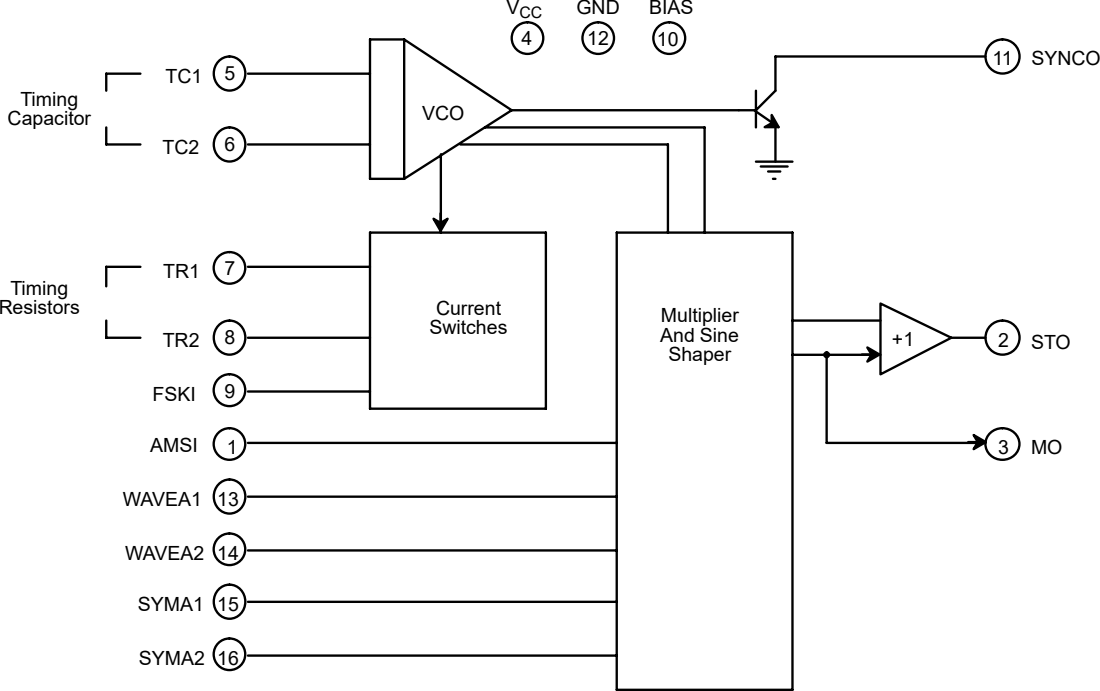
[picture p81: page 1]
11 SYNCO; VCO; VCC; GND; BIAS; Timing Capacitor; Timing Resistors; FSKI; AMSI; Current; Switches; Multiplier; And Sine Shaper; 2 STO; 13WAVEA1; 14WAVEA2; 15SYMA1; 16SYMA2
