LucaBrescia/theremin-psea/Immagini/schema_xr2206.pdf

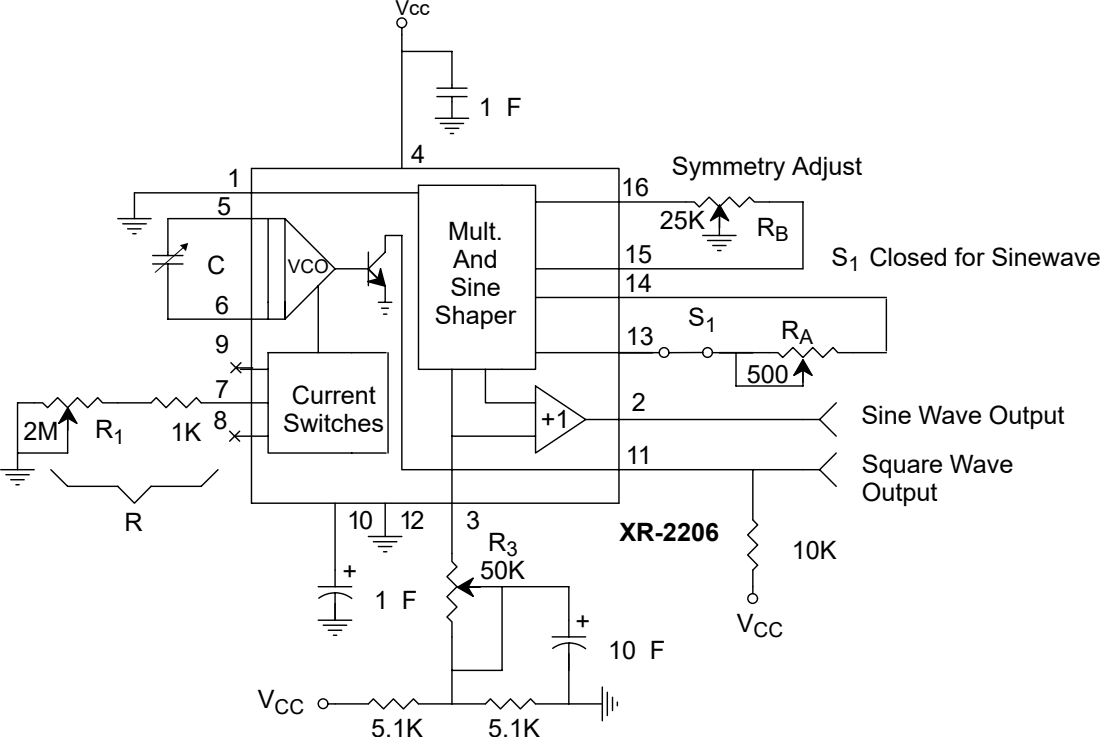
[picture p82: page 1]
Symmetry Adjust; Mult. And Sine Shaper; Current Switches; VCC; VCO; Vcc

S1 Closed for Sinewave

Sine Wave Output
Square Wave
Output
