LucaBrescia/theremin-psea/Immagini/Schematico Completo.pdf

A

A

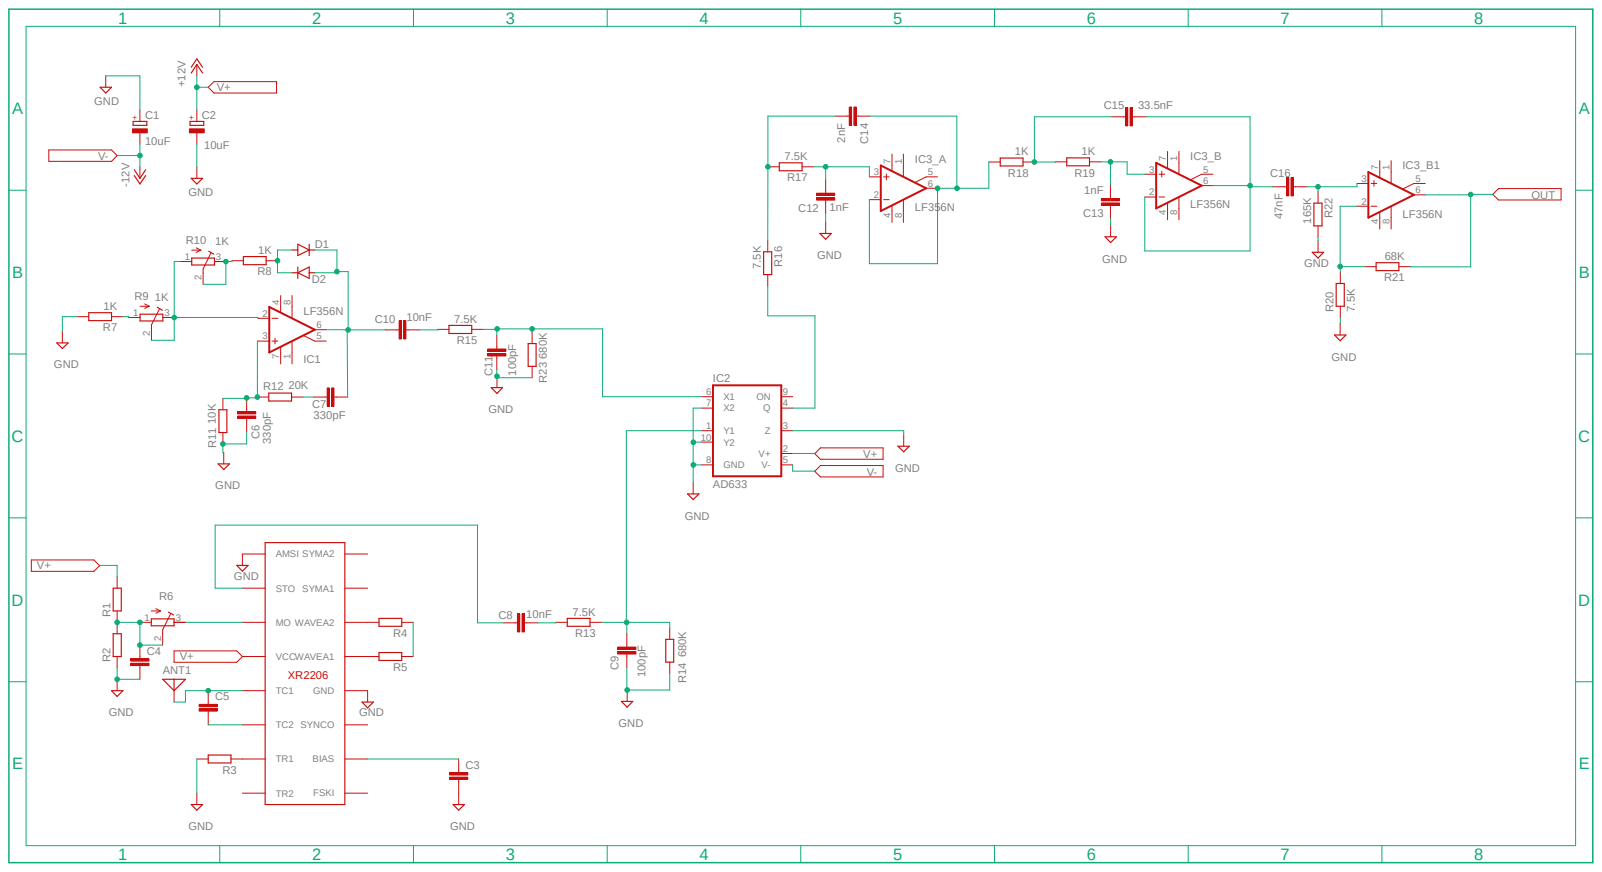
[picture p83: page 1]
