LucaBrescia/theremin-psea/Immagini/ad633_pinout.pdf

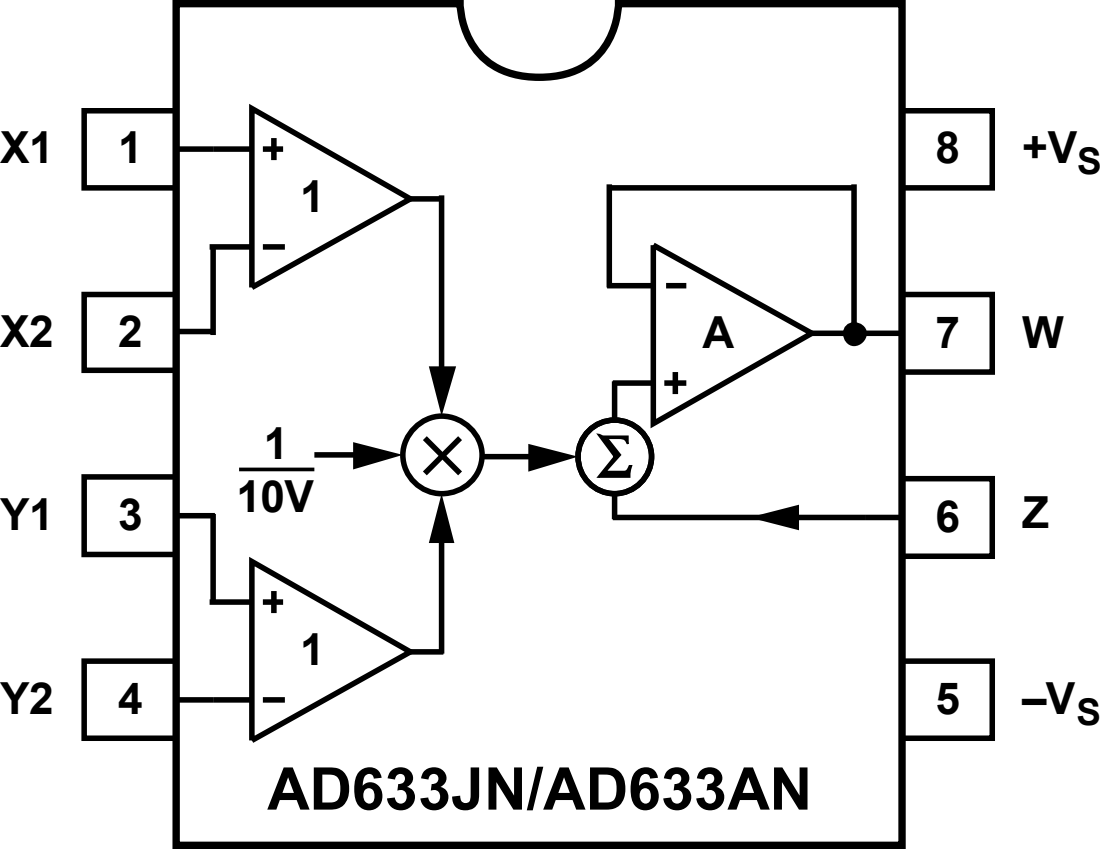
[picture p84: page 1]
