LucaBrescia/theremin-psea/Immagini/sch_osc_wien_cad.pdf

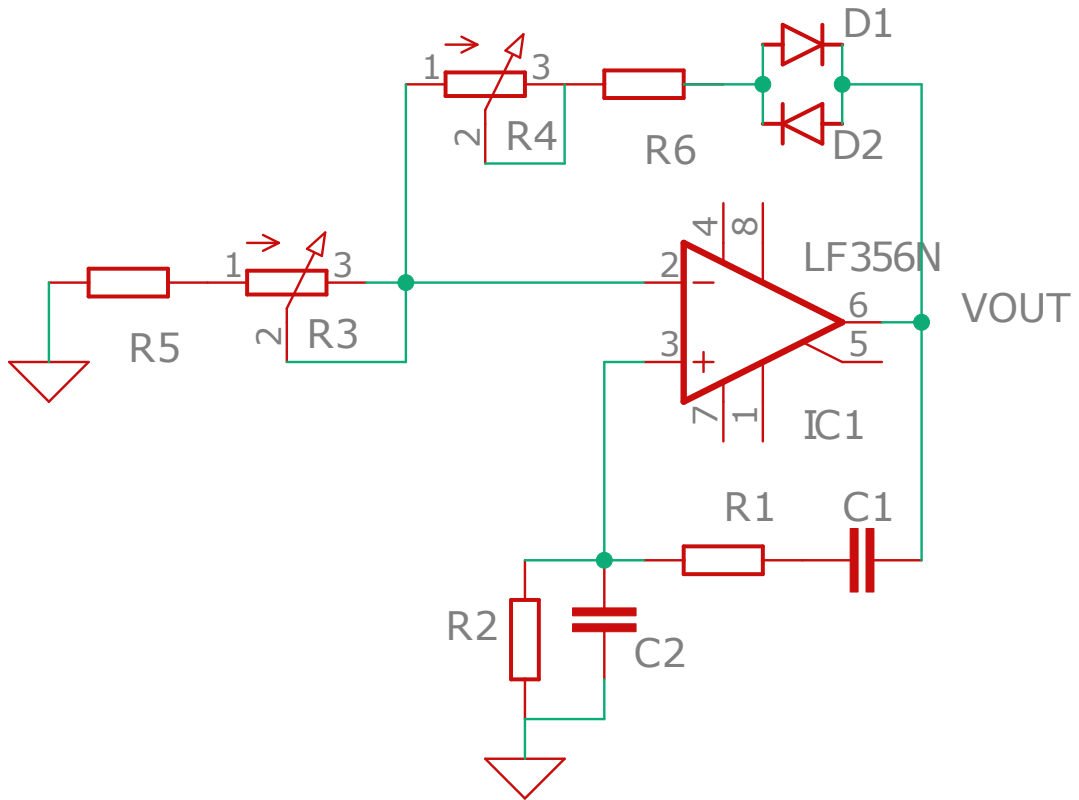
[picture p85: page 1]
