LucaBrescia/theremin-psea/Immagini/bode_hp1_ua741.pdf

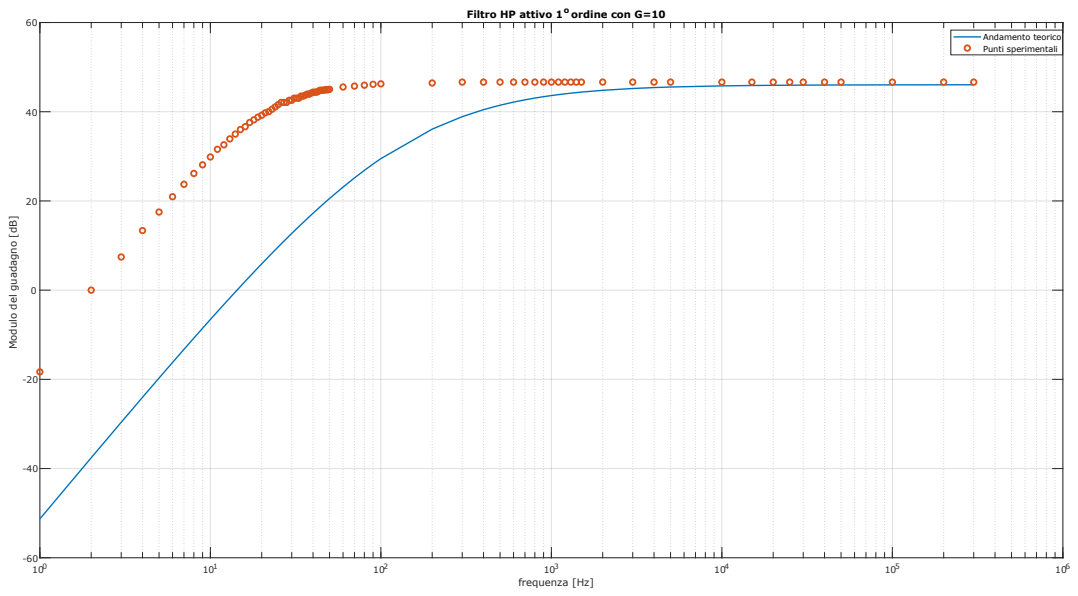
[picture p86: page 1]
frequenza [Hz]; ordine con G=10; Andamento teorico Punti sperimentali

Filtro HP attivo 1

Modulo del guadagno [dB]
