LucaBrescia/theremin-psea/sch/hp1.sch

## EAGLE design sch/hp1.sch (2023-11-25)

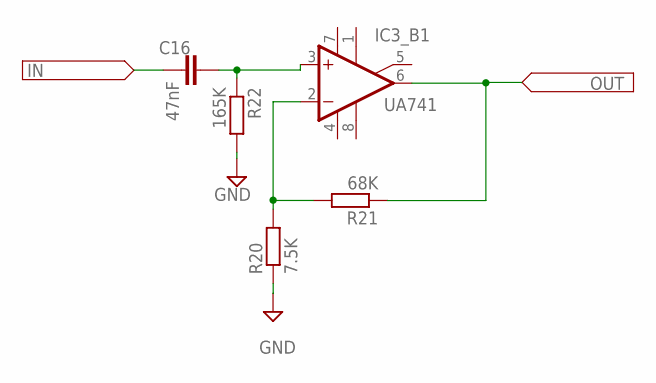
[picture p87: schematic hp1.sch]

Parts:
C16: 47nF; C025-025X050
IC3_B1: LF356N; DIL08
R20: 7.5K; 0207/10
R21: 68K; 0207/10
R22: 165K; 0207/10

Connections:
GND: R20.1, R22.2
unnamed: IC3_B1.6 (OUT), R21.1
unnamed: R20.2, R21.2
unnamed: C16.1, R22.1
