LucaBrescia/theremin-psea/sch/xr2206.sch

## EAGLE design sch/xr2206.sch (2023-11-25)

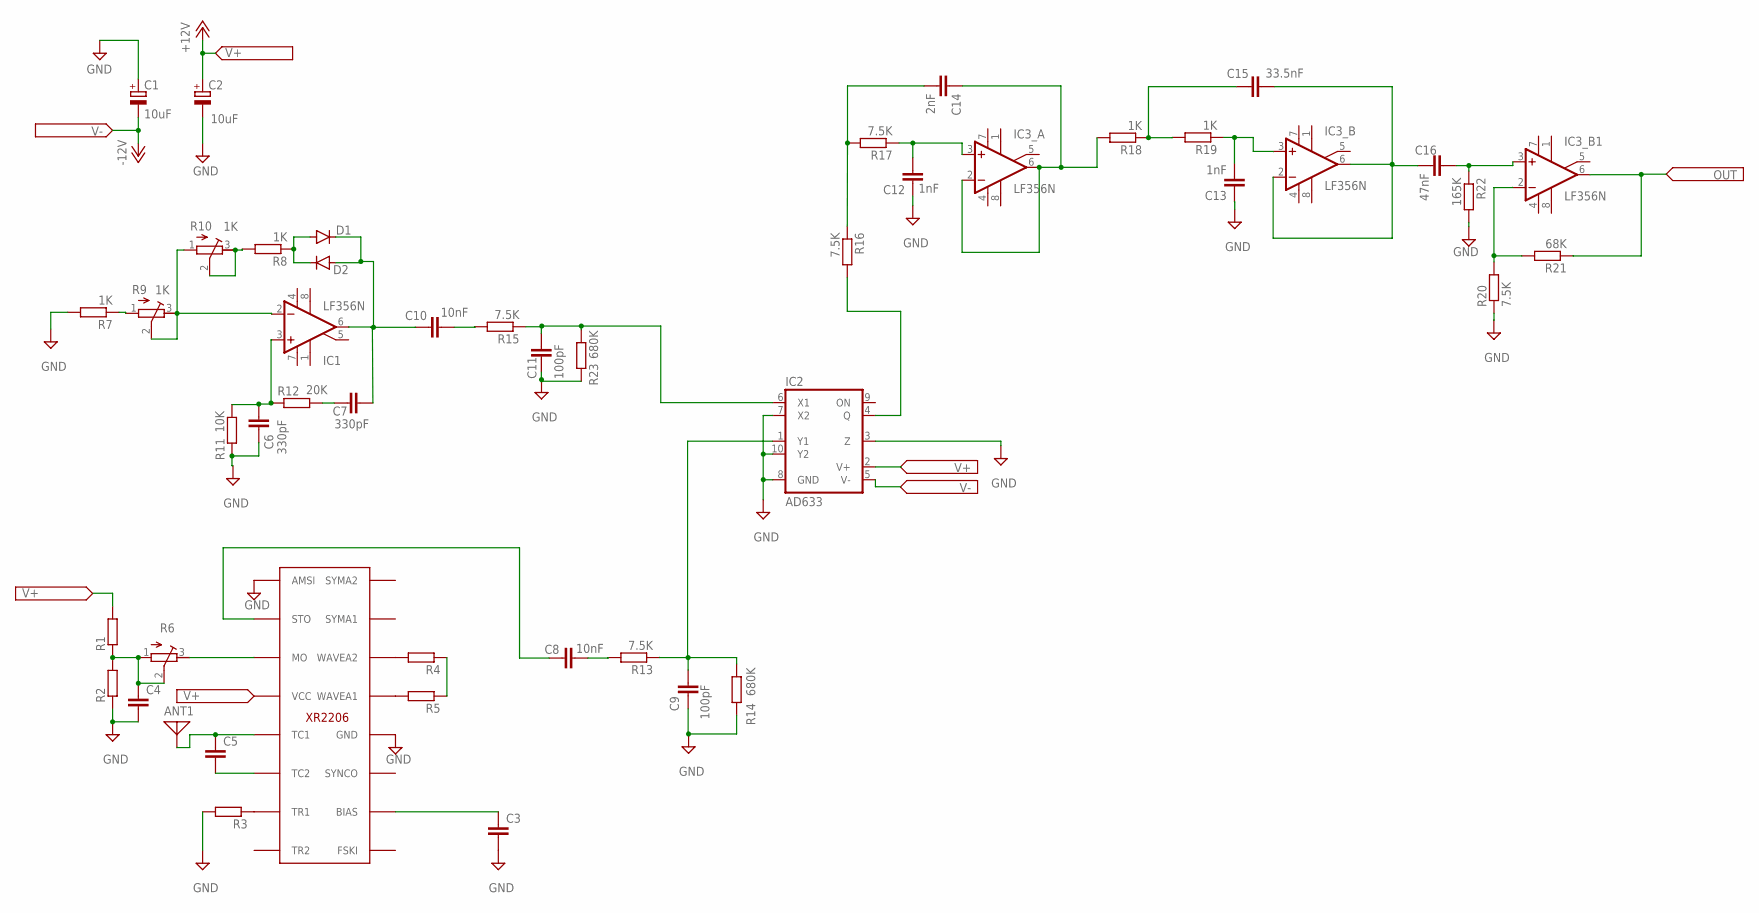
[picture p88: schematic xr2206.sch]

Parts:
ANT1: ANTENNA; PAD-01
C1, C2: 10uF; 085CS_1W
C3, C4, C5: C-EU025-025X050; C025-025X050
C6, C7: 330pF; C025-025X050
C8, C10: 10nF; C025-025X050
C9, C11: 100pF; C025-025X050
C12, C13: 1nF; C025-025X050
C14: 2nF; C025-025X050
C15: 33.5nF; C025-025X050
C16: 47nF; C025-025X050
D1, D2: 1N4004; DO41-10
IC1, IC3_A, IC3_B, IC3_B1: LF356N; DIL08
IC2: AD633; TO100
R1, R2, R3, R4, R5: R-EU_0207/10; 0207/10
R6: R-TRIMM5W; RTRIM5W
R7, R8, R18, R19: 1K; 0207/10
R9, R10: 1K; RTRIM5W
R11: 10K; 0207/10
R12: 20K; 0207/10
R13, R15, R16, R17, R20: 7.5K; 0207/10
R14, R23: 680K; 0207/10
R21: 68K; 0207/10
R22: 165K; 0207/10

Connections:
+12V: C2.+
-12V: C1.-
GND: C1.+, C2.-, C3.2, C4.2, C6.1, C9.2, C11.2, C12.1, C13.1, IC2.3 (Z), IC2.7 (X2), R2.1, R3.2, R7.2, R11.2, R14.2, R20.1, R22.2, R23.2
unnamed: R4.1, R5.1
unnamed: C4.1, R1.1, R2.2, R6.1 (A), R6.2 (S)
unnamed: ANT1.1, C5.1
unnamed: R8.2, R10.2 (S), R10.3 (E)
unnamed: D1.A, D2.C, R8.1
unnamed: C10.1, D1.C, D2.A
unnamed: C7.2, R12.2
unnamed: R7.1, R9.1 (A)
unnamed: R13.1, R14.1
unnamed: C6.2, IC1.3 (+IN), R11.1, R12.1
unnamed: C7.1, IC1.6 (OUT)
unnamed: IC1.2 (-IN), R9.2 (S), R9.3 (E), R10.1 (A)
unnamed: C8.2, R13.2
unnamed: C11.1, R15.1
unnamed: C10.2, R15.2
unnamed: IC2.6 (X1), R23.1
unnamed: C14.1, IC3_A.2 (-IN), IC3_A.6 (OUT), R18.2
unnamed: C12.2, R17.1
unnamed: C14.2, R16.1, R17.2
unnamed: IC2.4 (Q), R16.2
unnamed: C15.1, IC3_B.2 (-IN), IC3_B.6 (OUT)
unnamed: C13.2, R19.1
unnamed: C15.2, R18.1, R19.2
unnamed: IC3_B1.6 (OUT), R21.1
unnamed: R20.2, R21.2
unnamed: C16.1, R22.1
