LucaBrescia/theremin-psea/(commit log)

2022-04-16 Prova di una modifica
2022-04-30 Update README.md
    Inseriti commenti su circuito xr2206
2022-10-09 todo list per l'ultima parte di progetto
2022-10-27 Aggiunto schematico oscillatore wien
2022-10-30 Modifiche di testo e forma
2022-11-06 Aggiunta schematico completo a Relazione
    [xr2206.sch]
2022-11-07 Sistemato schematico completo e aggiunto verticale
2022-11-07 Aggiunto schema hp1. Correggere ua741 sch_comp
    [hp1.sch, xr2206.sch]
2022-11-20 Inseriti elenchi di figure e tabelle
2022-12-17 Aggiunto F0 all'oscillatore di wien
2022-12-17 Aggiunta F0 all'oscillatore di wien 2.2
2022-12-30 Oscillatore di wien corretto
2023-01-02 Aggiunte de 02012023
2023-11-25 Ultime modifiche
    [hp1.sch, xr2206.sch]
2023-11-25 Modifiche oscillatore di wien
